daviskacer/odin/hardware/analog.kicad_sch

## KiCad design hardware/analog.kicad_sch (2026-10-21)

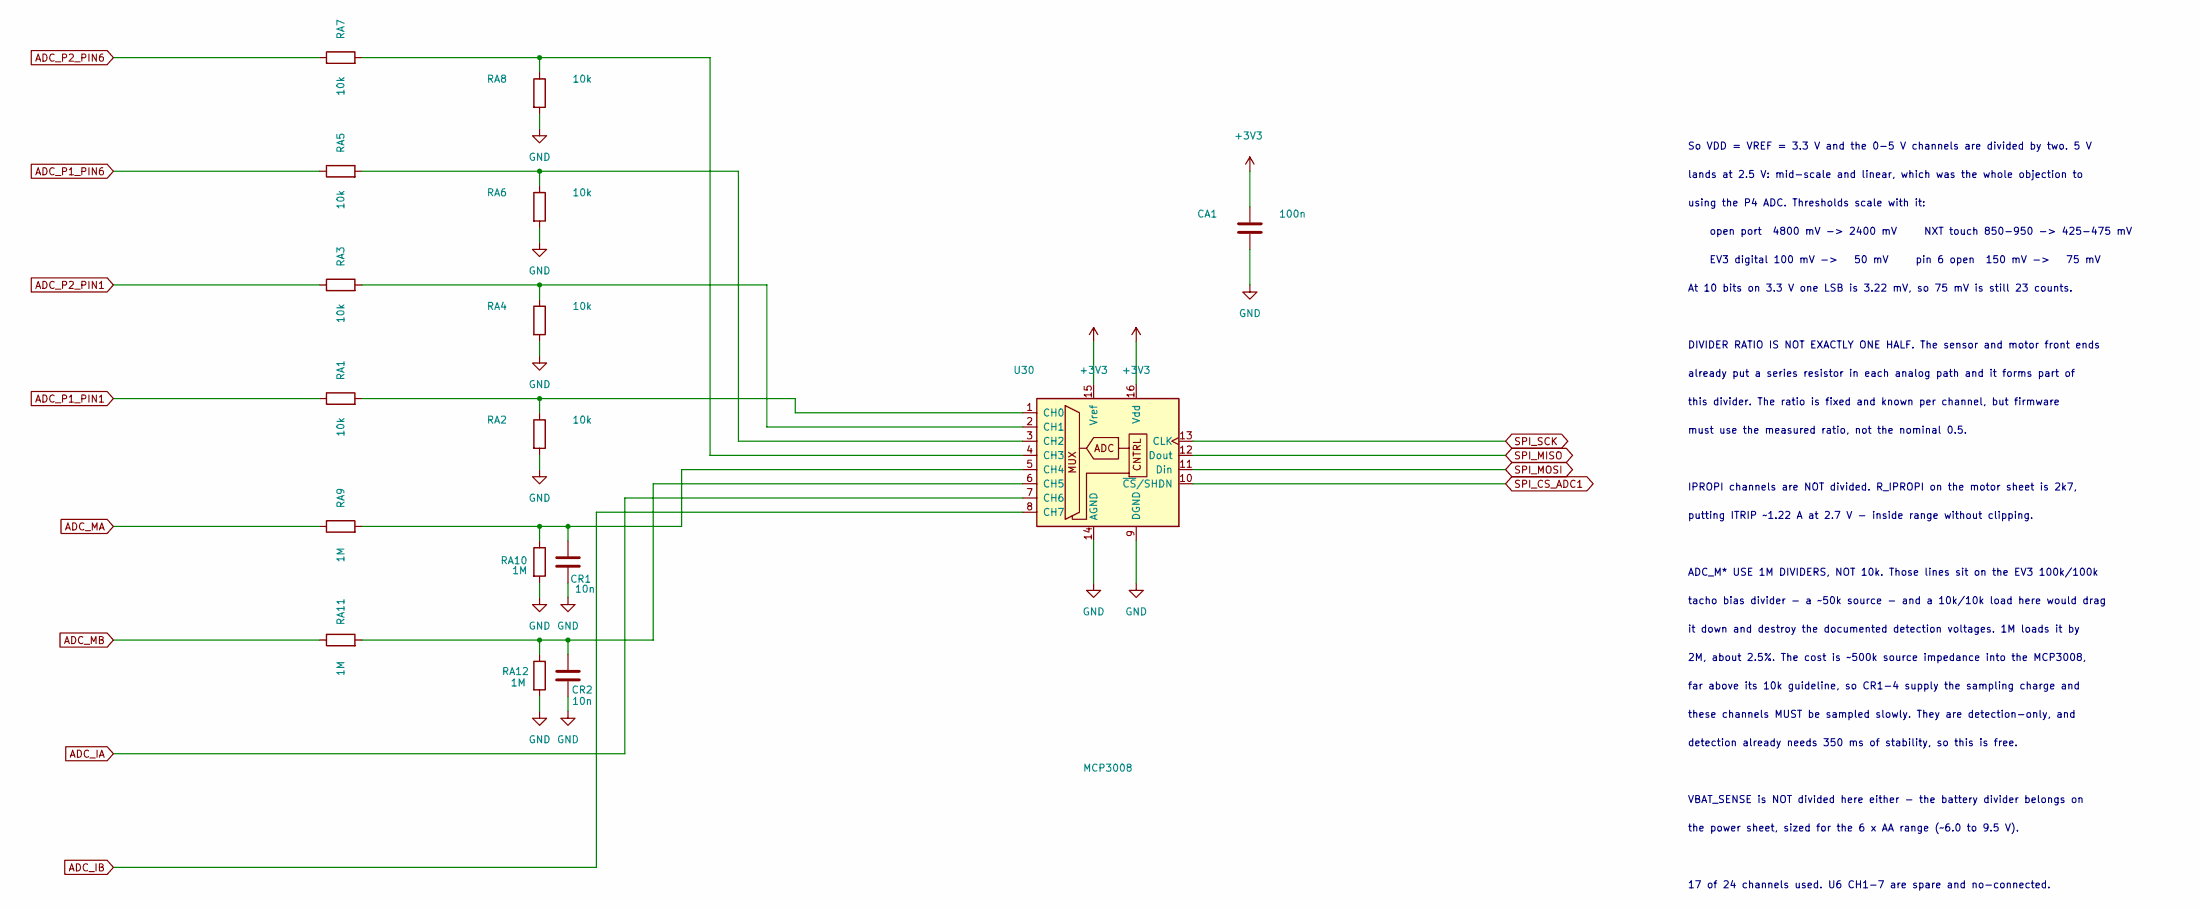
[picture p2: schematic analog.kicad_sch]

Parts:
CA1: 100n; C_0603_1608Metric
CR1, CR2: 10n; C_0603_1608Metric
RA1, RA2, RA3, RA4, RA5, RA6, RA7, RA8: 10k; R_0603_1608Metric
RA9, RA10, RA11, RA12: 1M; R_0603_1608Metric
U30: MCP3008; DIP-16_W7.62mm

Connections:
+3V3: CA1.1, U30.15 (Vref), U30.16 (Vdd)
ADC_IA: U30.7 (CH6)
ADC_IB: U30.8 (CH7)
ADC_MA: RA9.1
ADC_MB: RA11.1
ADC_P1_PIN1: RA1.1
ADC_P1_PIN6: RA5.1
ADC_P2_PIN1: RA3.1
ADC_P2_PIN6: RA7.1
GND: CA1.2, CR1.2, CR2.2, RA2.2, RA4.2, RA6.2, RA8.2, RA10.2, RA12.2, U30.9 (DGND), U30.14 (AGND)
unnamed: CR1.1, RA9.2, RA10.1, U30.5 (CH4)
unnamed: CR2.1, RA11.2, RA12.1, U30.6 (CH5)
unnamed: RA1.2, RA2.1, U30.1 (CH0)
unnamed: RA3.2, RA4.1, U30.2 (CH1)
unnamed: RA5.2, RA6.1, U30.3 (CH2)
unnamed: RA7.2, RA8.1, U30.4 (CH3)
SPI_CS_ADC1: U30.10 (~CS/SHDN)
SPI_MISO: U30.12 (Dout)
SPI_MOSI: U30.11 (Din)
SPI_SCK: U30.13 (CLK)

Notes on the sheet:
these channels MUST be sampled slowly. They are detection-only, and
At 10 bits on 3.3 V one LSB is 3.22 mV, so 75 mV is still 23 counts.
tacho bias divider - a ~50k source - and a 10k/10k load here would drag
putting ITRIP ~1.22 A at 2.7 V - inside range without clipping.
detection already needs 350 ms of stability, so this is free.
IPROPI channels are NOT divided. R_IPROPI on the motor sheet is 2k7,
ADC_M* USE 1M DIVIDERS, NOT 10k. Those lines sit on the EV3 100k/100k
must use the measured ratio, not the nominal 0.5.
lands at 2.5 V: mid-scale and linear, which was the whole objection to
already put a series resistor in each analog path and it forms part of
using the P4 ADC. Thresholds scale with it:
open port 4800 mV -> 2400 mV NXT touch 850-950 -> 425-475 mV
the power sheet, sized for the 6 x AA range (~6.0 to 9.5 V).
VBAT_SENSE is NOT divided here either - the battery divider belongs on
2M, about 2.5%. The cost is ~500k source impedance into the MCP3008,
far above its 10k guideline, so CR1-4 supply the sampling charge and
17 of 24 channels used. U6 CH1-7 are spare and no-connected.
EV3 digital 100 mV -> 50 mV pin 6 open 150 mV -> 75 mV
it down and destroy the documented detection voltages. 1M loads it by
So VDD = VREF = 3.3 V and the 0-5 V channels are divided by two. 5 V
this divider. The ratio is fixed and known per channel, but firmware
DIVIDER RATIO IS NOT EXACTLY ONE HALF. The sensor and motor front ends
