daviskacer/odin/hardware/devio.kicad_sch

## KiCad design hardware/devio.kicad_sch (2026-10-21)

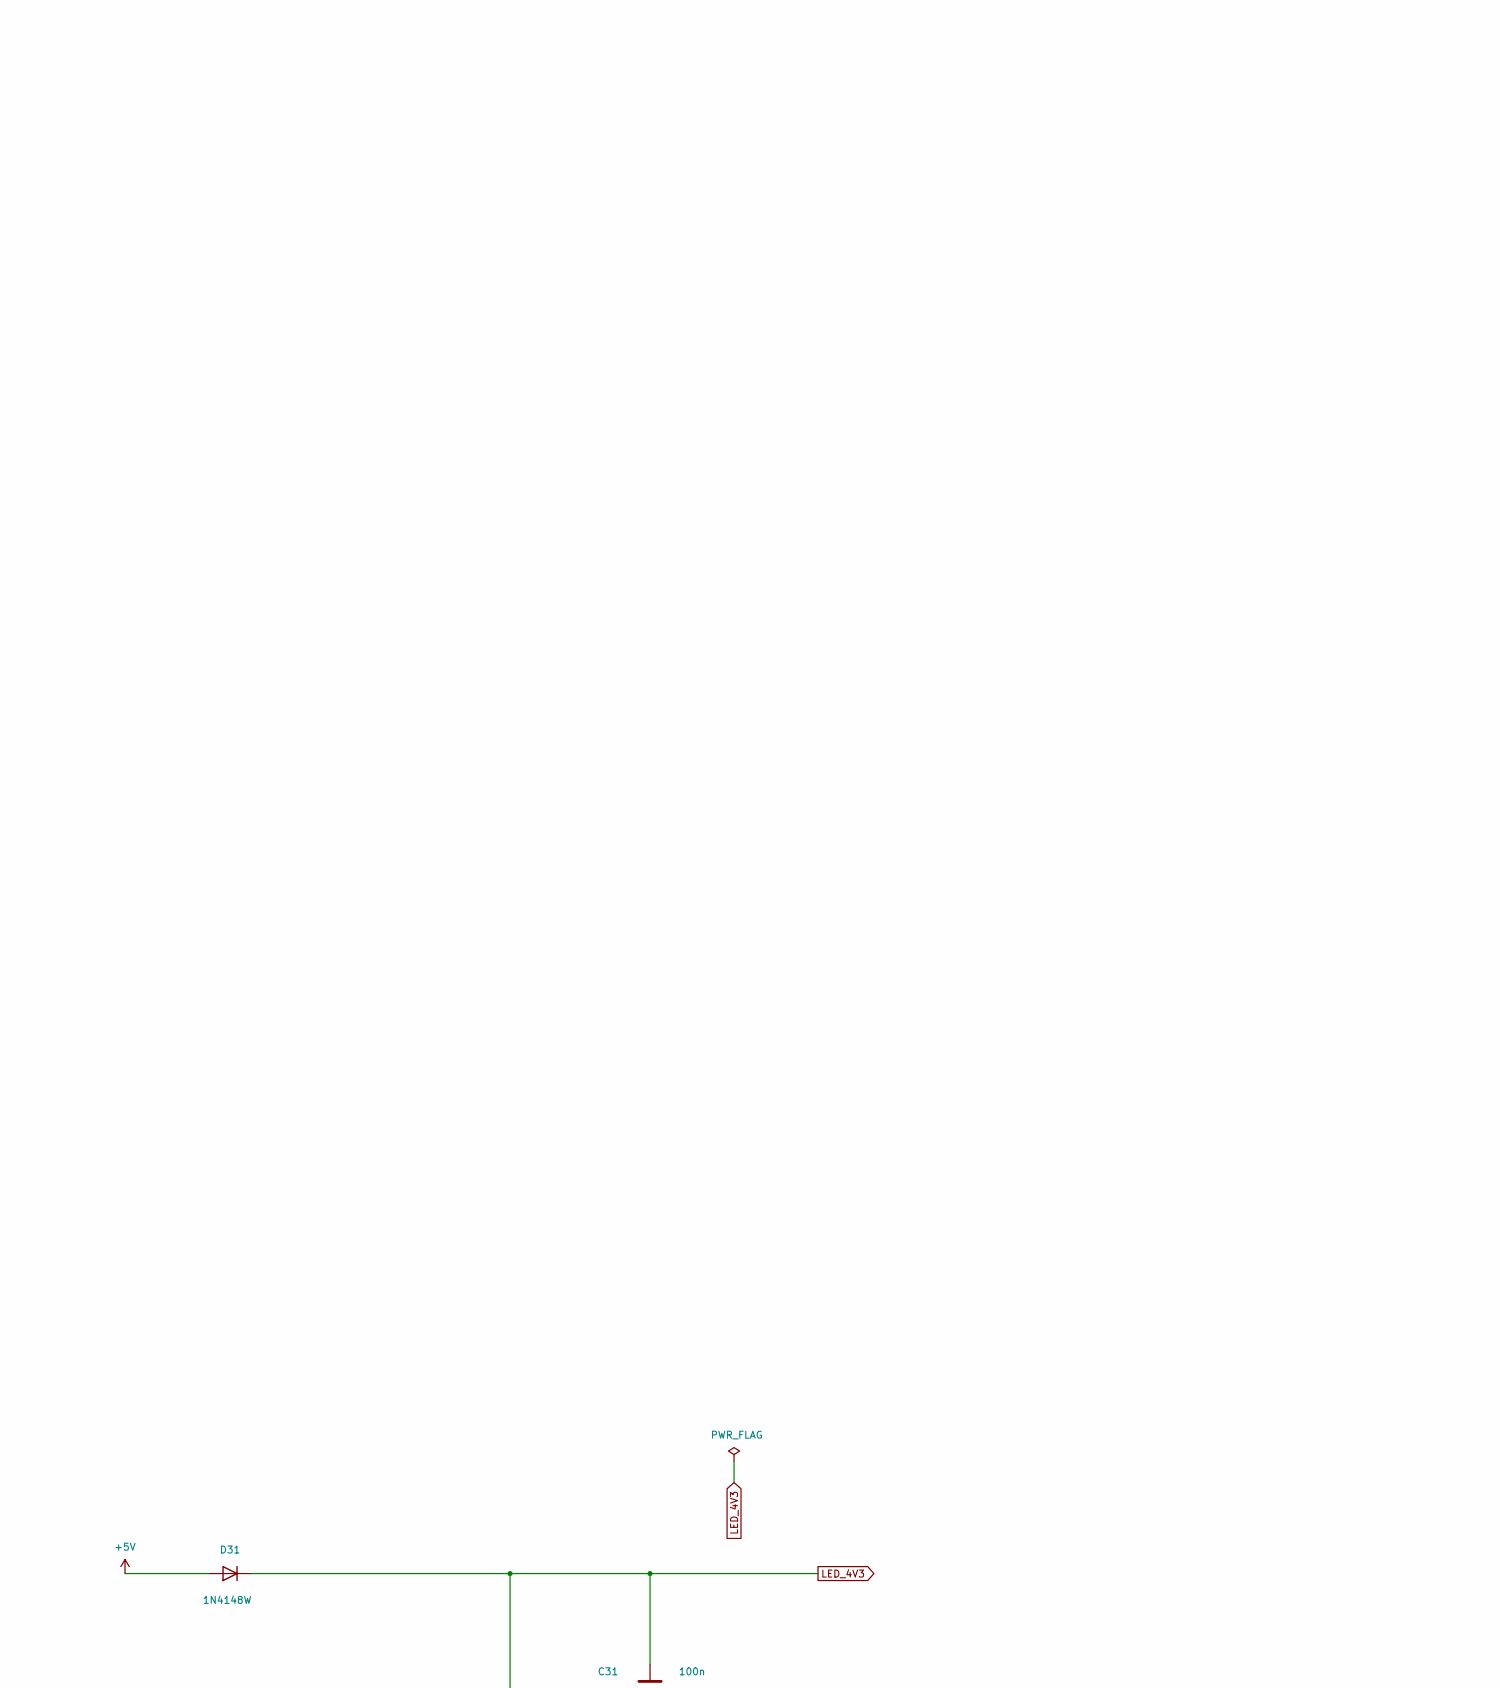
[picture p3: schematic devio.kicad_sch, part in row 1, column 1]

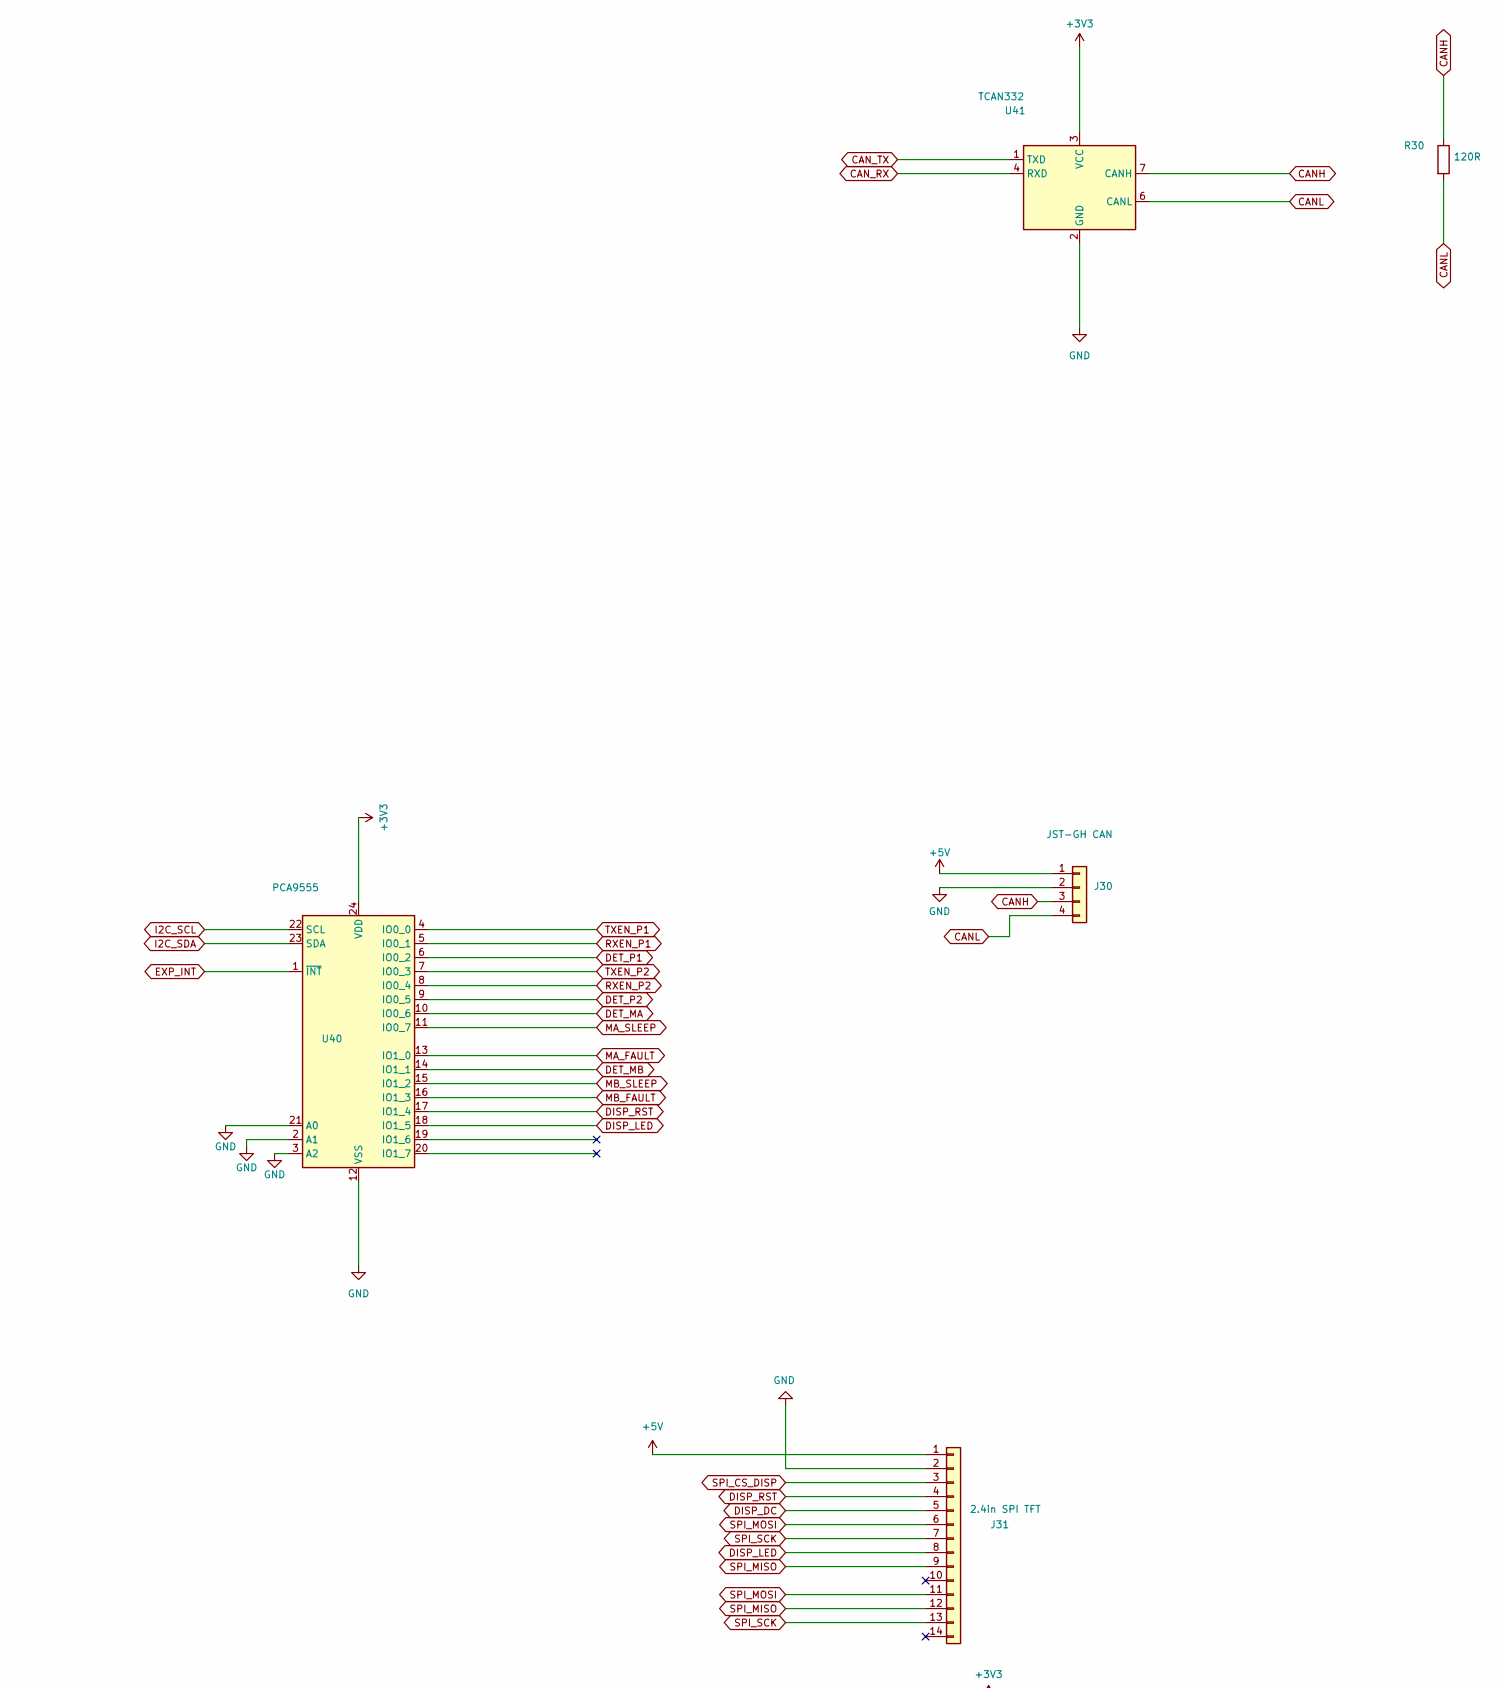
[picture p4: schematic devio.kicad_sch, part in row 1, column 2]

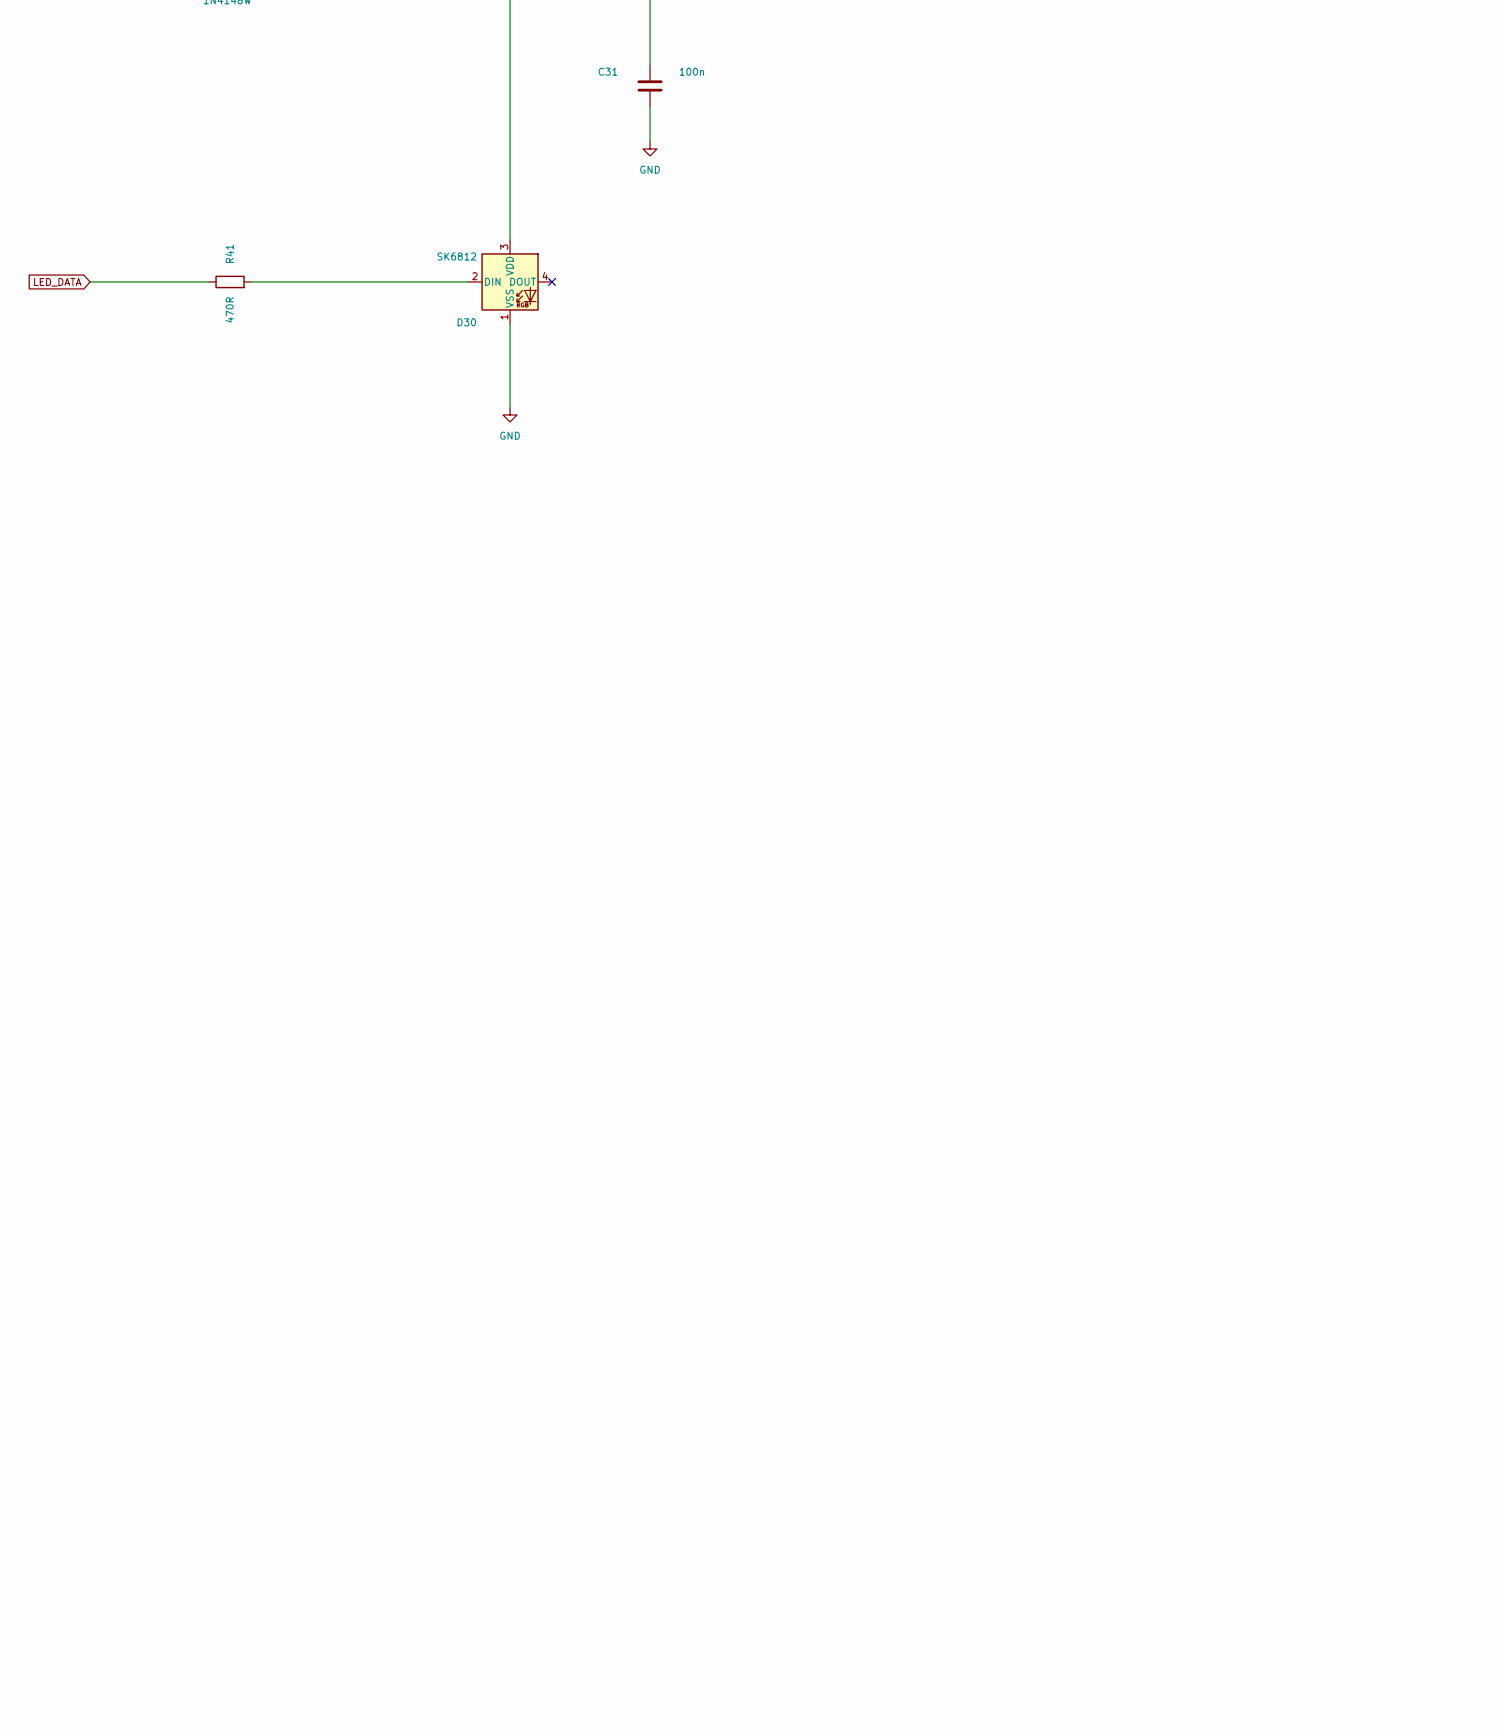
[picture p5: schematic devio.kicad_sch, part in row 2, column 1]

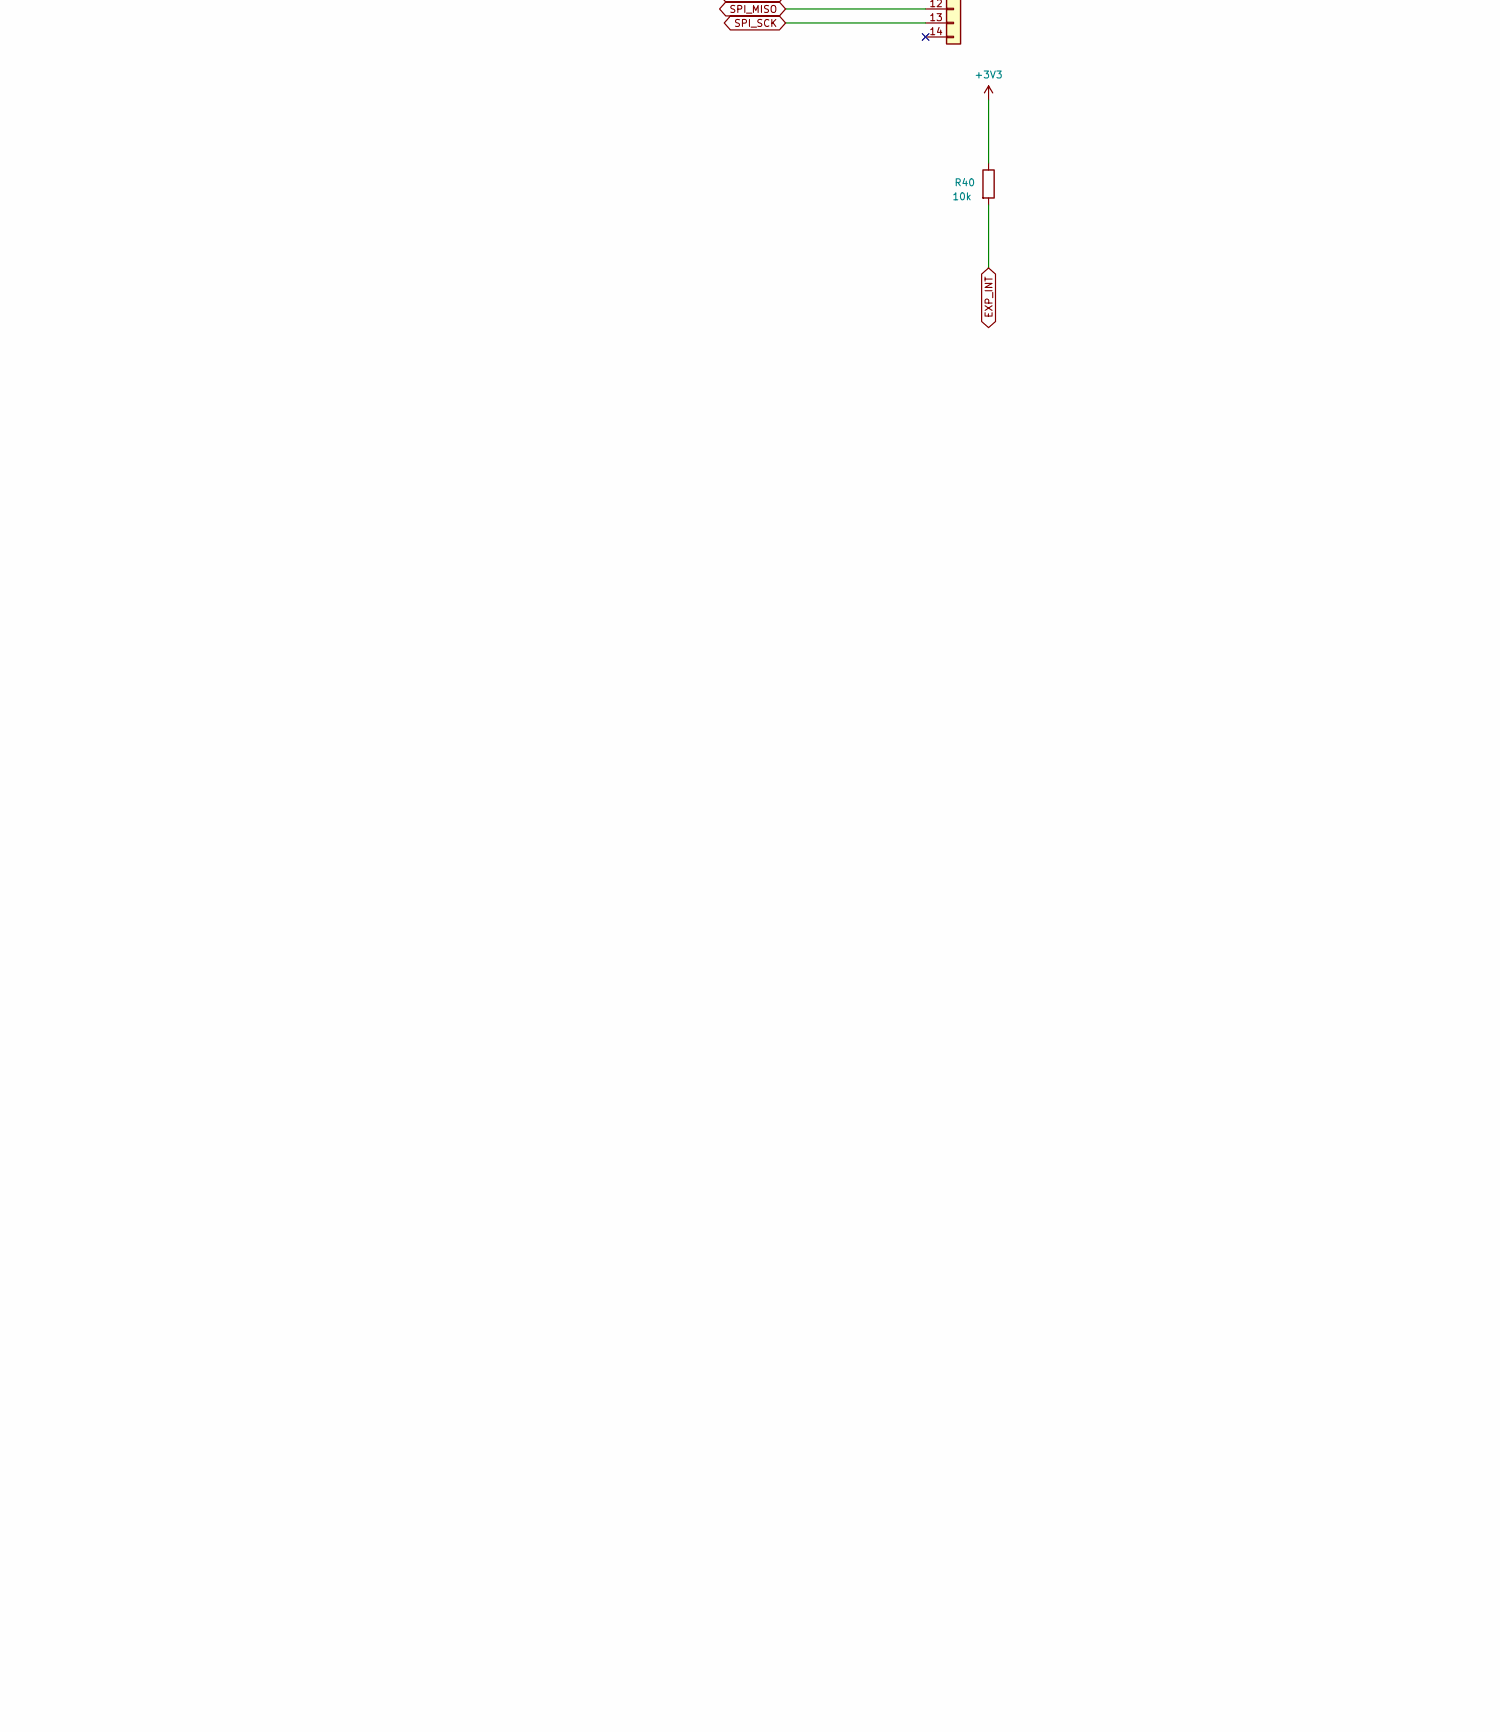
[picture p6: schematic devio.kicad_sch, part in row 2, column 2]

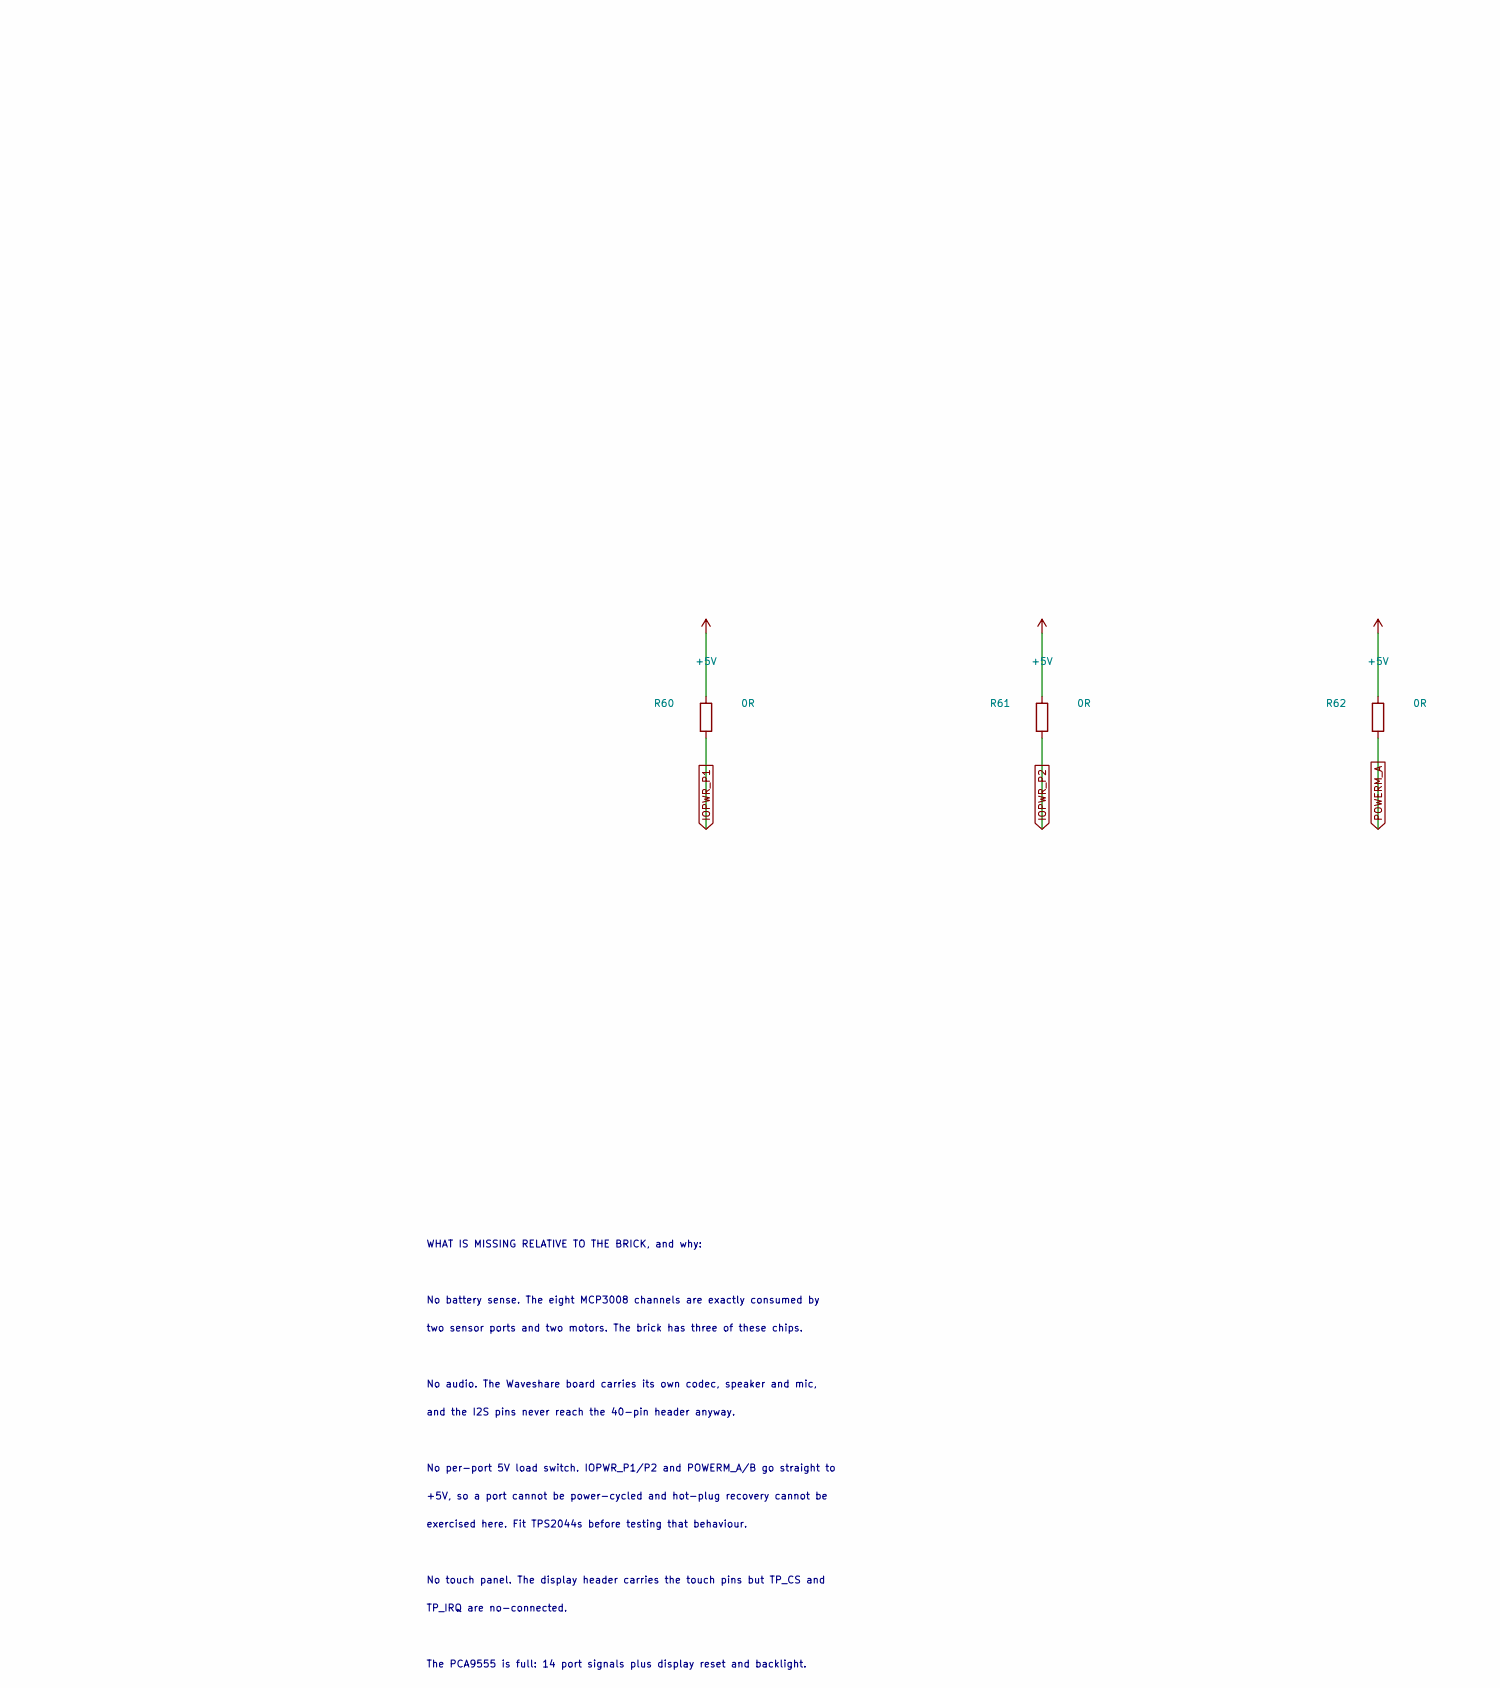
[picture p7: schematic devio.kicad_sch, part in row 3, column 1]

Parts:
C31: 100n; C_0603_1608Metric
D30: SK6812; LED_OPSCO_SK6812_PLCC4_5.0x5.0mm_P3.1mm
D31: 1N4148W; D_SOD-123
J30: JST-GH CAN; JST_GH_SM04B-GHS-TB_1x04-1MP_P1.25mm_Horizontal
J31: 2.4in SPI TFT; PinHeader_1x14_P2.54mm_Vertical
R30: 120R; R_0805_2012Metric
R40: 10k; R_0603_1608Metric
R41: 470R; R_0603_1608Metric
R60, R61, R62, R63: 0R; R_0805_2012Metric
U40: PCA9555; TSSOP-24_4.4x7.8mm_P0.65mm
U41: TCAN332; SOIC-8_3.9x4.9mm_P1.27mm

Connections:
+3V3: R40.1, U40.24 (VDD), U41.3 (VCC)
+5V: D31.2 (A), J30.1, J31.1, R60.1, R61.1, R62.1, R63.1
CANH: J30.3, R30.1, U41.7 (CANH)
CANL: J30.4, R30.2, U41.6 (CANL)
CAN_RX: U41.4 (RXD)
CAN_TX: U41.1 (TXD)
DET_MA: U40.10 (IO0_6)
DET_MB: U40.14 (IO1_1)
DET_P1: U40.6 (IO0_2)
DET_P2: U40.9 (IO0_5)
DISP_DC: J31.5
DISP_LED: J31.8, U40.18 (IO1_5)
DISP_RST: J31.4, U40.17 (IO1_4)
EXP_INT: R40.2, U40.1 (~INT)
GND: C31.2, D30.1 (VSS), J30.2, J31.2, U40.2 (A1), U40.3 (A2), U40.12 (VSS), U40.21 (A0), U41.2 (GND)
I2C_SCL: U40.22 (SCL)
I2C_SDA: U40.23 (SDA)
IOPWR_P1: R60.2
IOPWR_P2: R61.2
LED_4V3: C31.1, D30.3 (VDD), D31.1 (K)
LED_DATA: R41.1
MA_FAULT: U40.13 (IO1_0)
MA_SLEEP: U40.11 (IO0_7)
MB_FAULT: U40.16 (IO1_3)
MB_SLEEP: U40.15 (IO1_2)
unnamed: D30.2 (DIN), R41.2
POWERM_A: R62.2
POWERM_B: R63.2
RXEN_P1: U40.5 (IO0_1)
RXEN_P2: U40.8 (IO0_4)
SPI_CS_DISP: J31.3
SPI_MISO: J31.9, J31.12
SPI_MOSI: J31.6, J31.11
SPI_SCK: J31.7, J31.13
TXEN_P1: U40.4 (IO0_0)
TXEN_P2: U40.7 (IO0_3)

Notes on the sheet:
No audio. The Waveshare board carries its own codec, speaker and mic,
WHAT IS MISSING RELATIVE TO THE BRICK, and why:
two sensor ports and two motors. The brick has three of these chips.
No per-port 5V load switch. IOPWR_P1/P2 and POWERM_A/B go straight to
exercised here. Fit TPS2044s before testing that behaviour.
TP_IRQ are no-connected.
No touch panel. The display header carries the touch pins but TP_CS and
+5V, so a port cannot be power-cycled and hot-plug recovery cannot be
The PCA9555 is full: 14 port signals plus display reset and backlight.
and the I2S pins never reach the 40-pin header anyway.
No battery sense. The eight MCP3008 channels are exactly consumed by
