daviskacer/odin/hardware/header.kicad_sch

## KiCad design hardware/header.kicad_sch (2026-10-21)

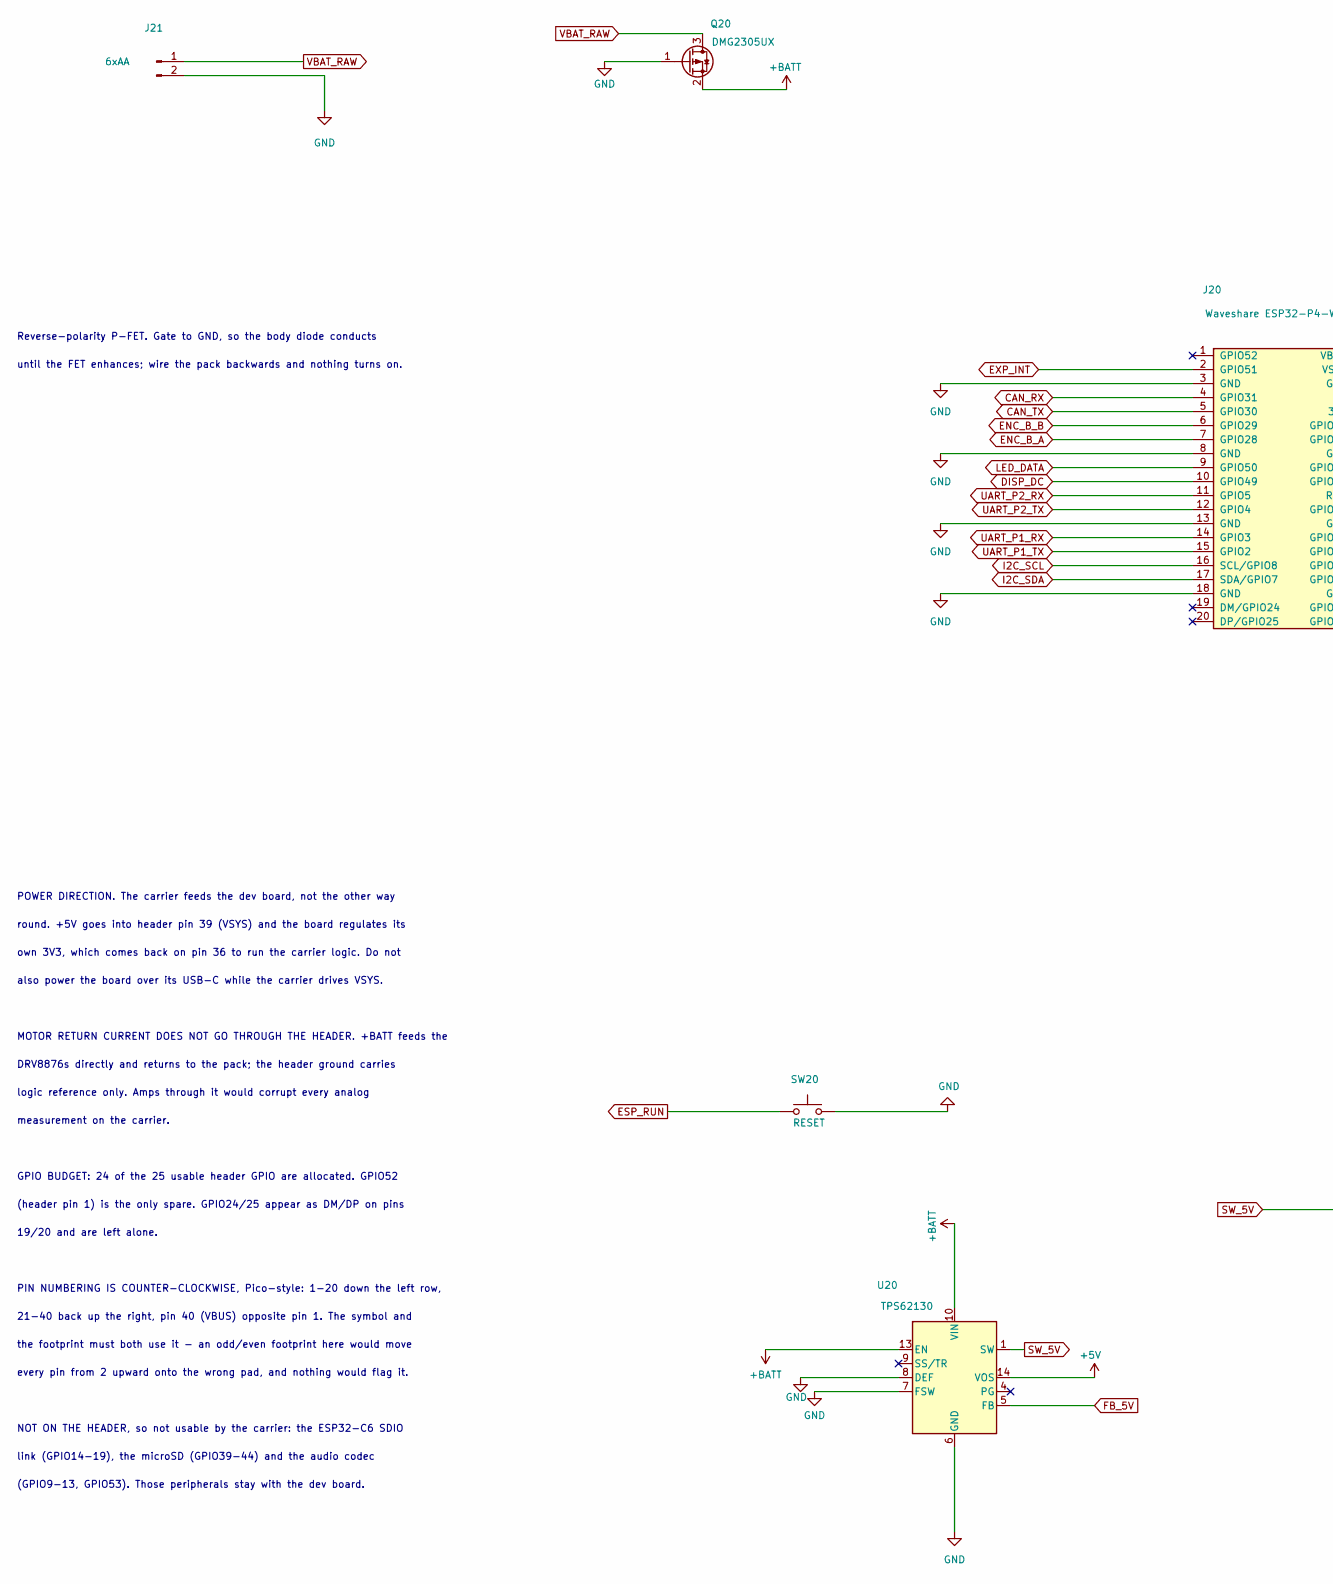
[picture p8: schematic header.kicad_sch, part in row 1, column 1]

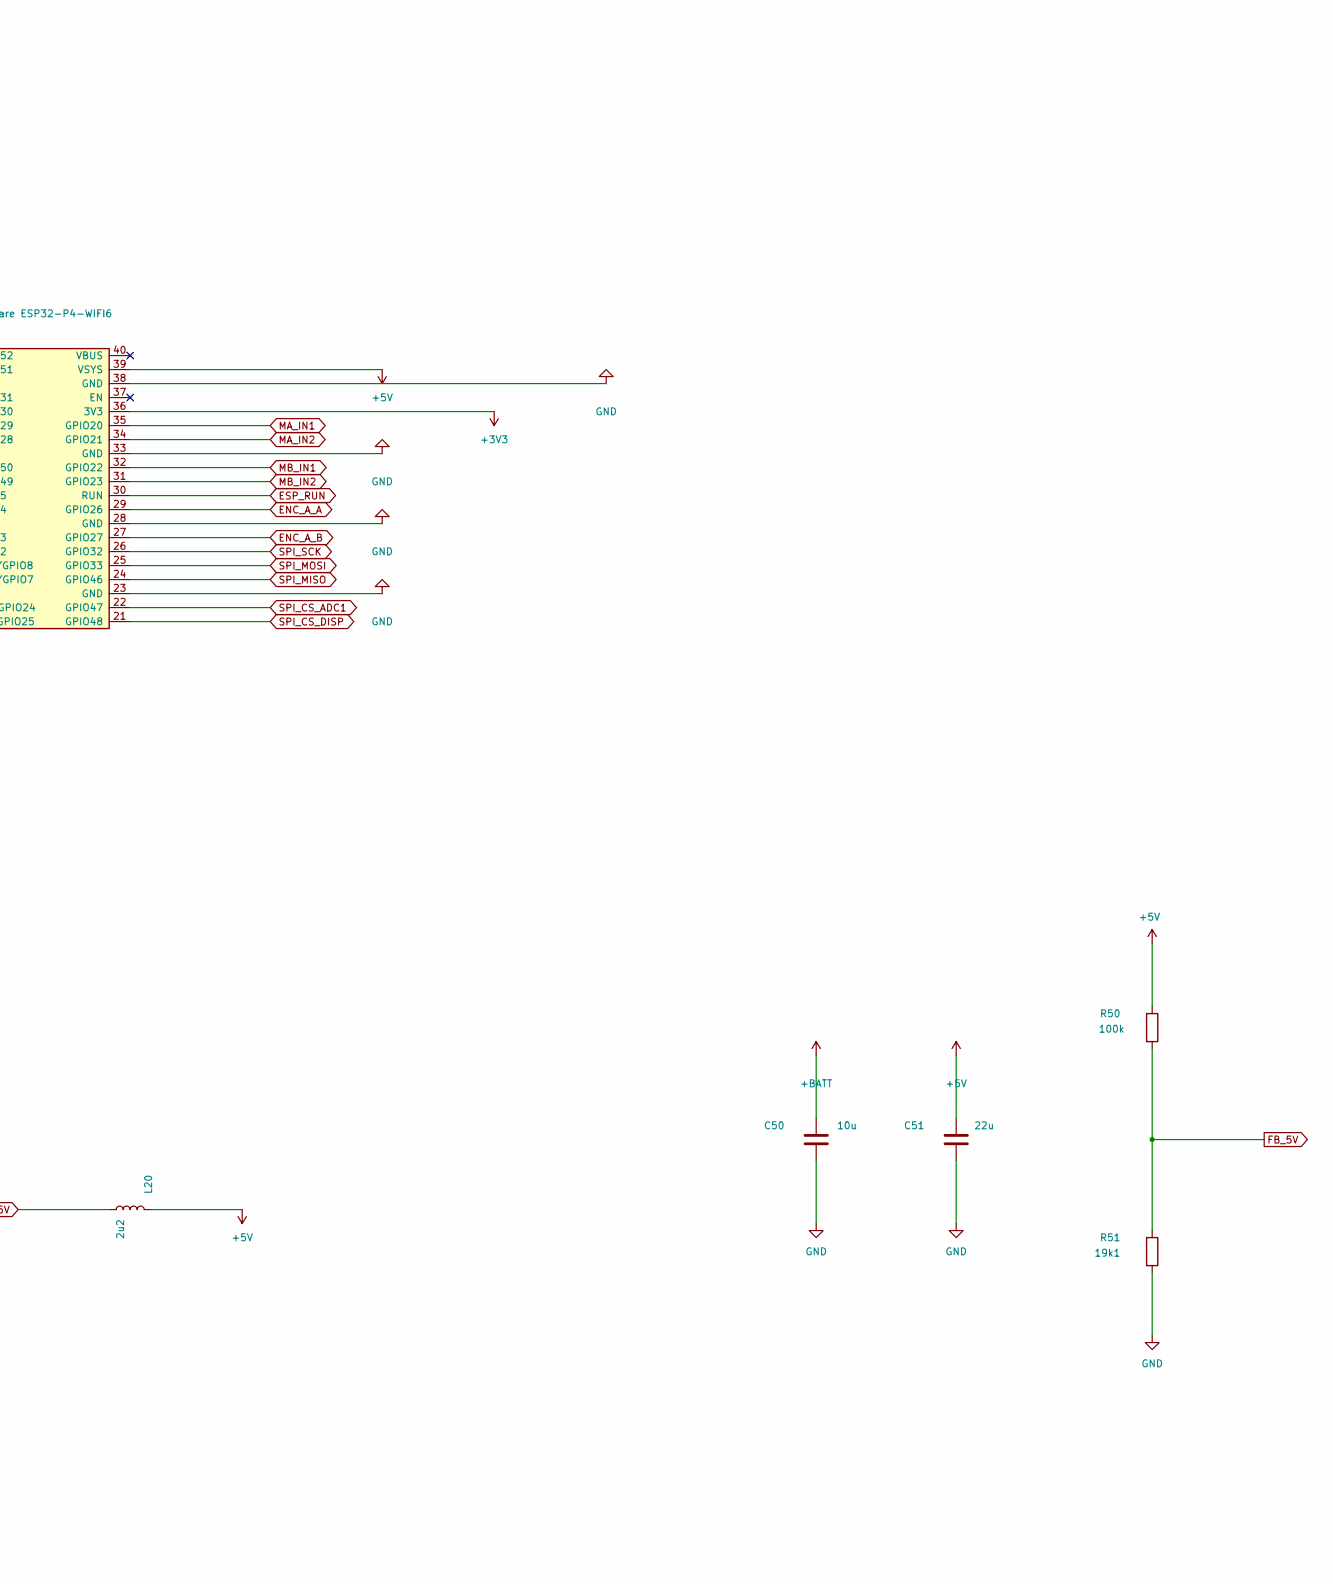
[picture p9: schematic header.kicad_sch, part in row 1, column 2]

Parts:
C50: 10u; C_0805_2012Metric
C51: 22u; C_0805_2012Metric
J20: Waveshare ESP32-P4-WIFI6; Waveshare_ESP32-P4-WIFI6_2x20_P2.54mm_Socket
J21: 6xAA
L20: 2u2
Q20: DMG2305UX; SOT-23
R50: 100k; R_0603_1608Metric
R51: 19k1; R_0603_1608Metric
SW20: RESET; SW_Push_1P1T_NO_CK_KMR2
U20: TPS62130

Connections:
+3V3: J20.36 (3V3)
+5V: C51.1, J20.39 (VSYS), L20.2, R50.1, U20.14 (VOS)
+BATT: C50.1, Q20.2 (S), U20.10 (VIN), U20.11 (VIN), U20.12 (VIN), U20.13 (EN)
CAN_RX: J20.4 (GPIO31)
CAN_TX: J20.5 (GPIO30)
DISP_DC: J20.10 (GPIO49)
ENC_A_A: J20.29 (GPIO26)
ENC_A_B: J20.27 (GPIO27)
ENC_B_A: J20.7 (GPIO28)
ENC_B_B: J20.6 (GPIO29)
ESP_RUN: J20.30 (RUN), SW20.1
EXP_INT: J20.2 (GPIO51)
FB_5V: R50.2, R51.1, U20.5 (FB)
GND: C50.2, C51.2, J20.3 (GND), J20.8 (GND), J20.13 (GND), J20.18 (GND), J20.23 (GND), J20.28 (GND), J20.33 (GND), J20.38 (GND), J21.2, Q20.1 (G), R51.2, SW20.2, U20.6 (GND), U20.7 (FSW), U20.8 (DEF), U20.15 (GND), U20.16 (GND), U20.17 (GND)
I2C_SCL: J20.16 (SCL/GPIO8)
I2C_SDA: J20.17 (SDA/GPIO7)
LED_DATA: J20.9 (GPIO50)
MA_IN1: J20.35 (GPIO20)
MA_IN2: J20.34 (GPIO21)
MB_IN1: J20.32 (GPIO22)
MB_IN2: J20.31 (GPIO23)
SPI_CS_ADC1: J20.22 (GPIO47)
SPI_CS_DISP: J20.21 (GPIO48)
SPI_MISO: J20.24 (GPIO46)
SPI_MOSI: J20.25 (GPIO33)
SPI_SCK: J20.26 (GPIO32)
SW_5V: L20.1, U20.1 (SW), U20.2 (SW), U20.3 (SW)
UART_P1_RX: J20.14 (GPIO3)
UART_P1_TX: J20.15 (GPIO2)
UART_P2_RX: J20.11 (GPIO5)
UART_P2_TX: J20.12 (GPIO4)
VBAT_RAW: J21.1, Q20.3 (D)

Notes on the sheet:
the footprint must both use it - an odd/even footprint here would move
also power the board over its USB-C while the carrier drives VSYS.
21-40 back up the right, pin 40 (VBUS) opposite pin 1. The symbol and
(GPIO9-13, GPIO53). Those peripherals stay with the dev board.
Reverse-polarity P-FET. Gate to GND, so the body diode conducts
DRV8876s directly and returns to the pack; the header ground carries
NOT ON THE HEADER, so not usable by the carrier: the ESP32-C6 SDIO
link (GPIO14-19), the microSD (GPIO39-44) and the audio codec
until the FET enhances; wire the pack backwards and nothing turns on.
MOTOR RETURN CURRENT DOES NOT GO THROUGH THE HEADER. +BATT feeds the
measurement on the carrier.
POWER DIRECTION. The carrier feeds the dev board, not the other way
round. +5V goes into header pin 39 (VSYS) and the board regulates its
19/20 and are left alone.
PIN NUMBERING IS COUNTER-CLOCKWISE, Pico-style: 1-20 down the left row,
every pin from 2 upward onto the wrong pad, and nothing would flag it.
GPIO BUDGET: 24 of the 25 usable header GPIO are allocated. GPIO52
(header pin 1) is the only spare. GPIO24/25 appear as DM/DP on pins
logic reference only. Amps through it would corrupt every analog
own 3V3, which comes back on pin 36 to run the carrier logic. Do not
