daviskacer/odin/hardware/motor_ports.kicad_sch

## KiCad design hardware/motor_ports.kicad_sch (2026-10-21)

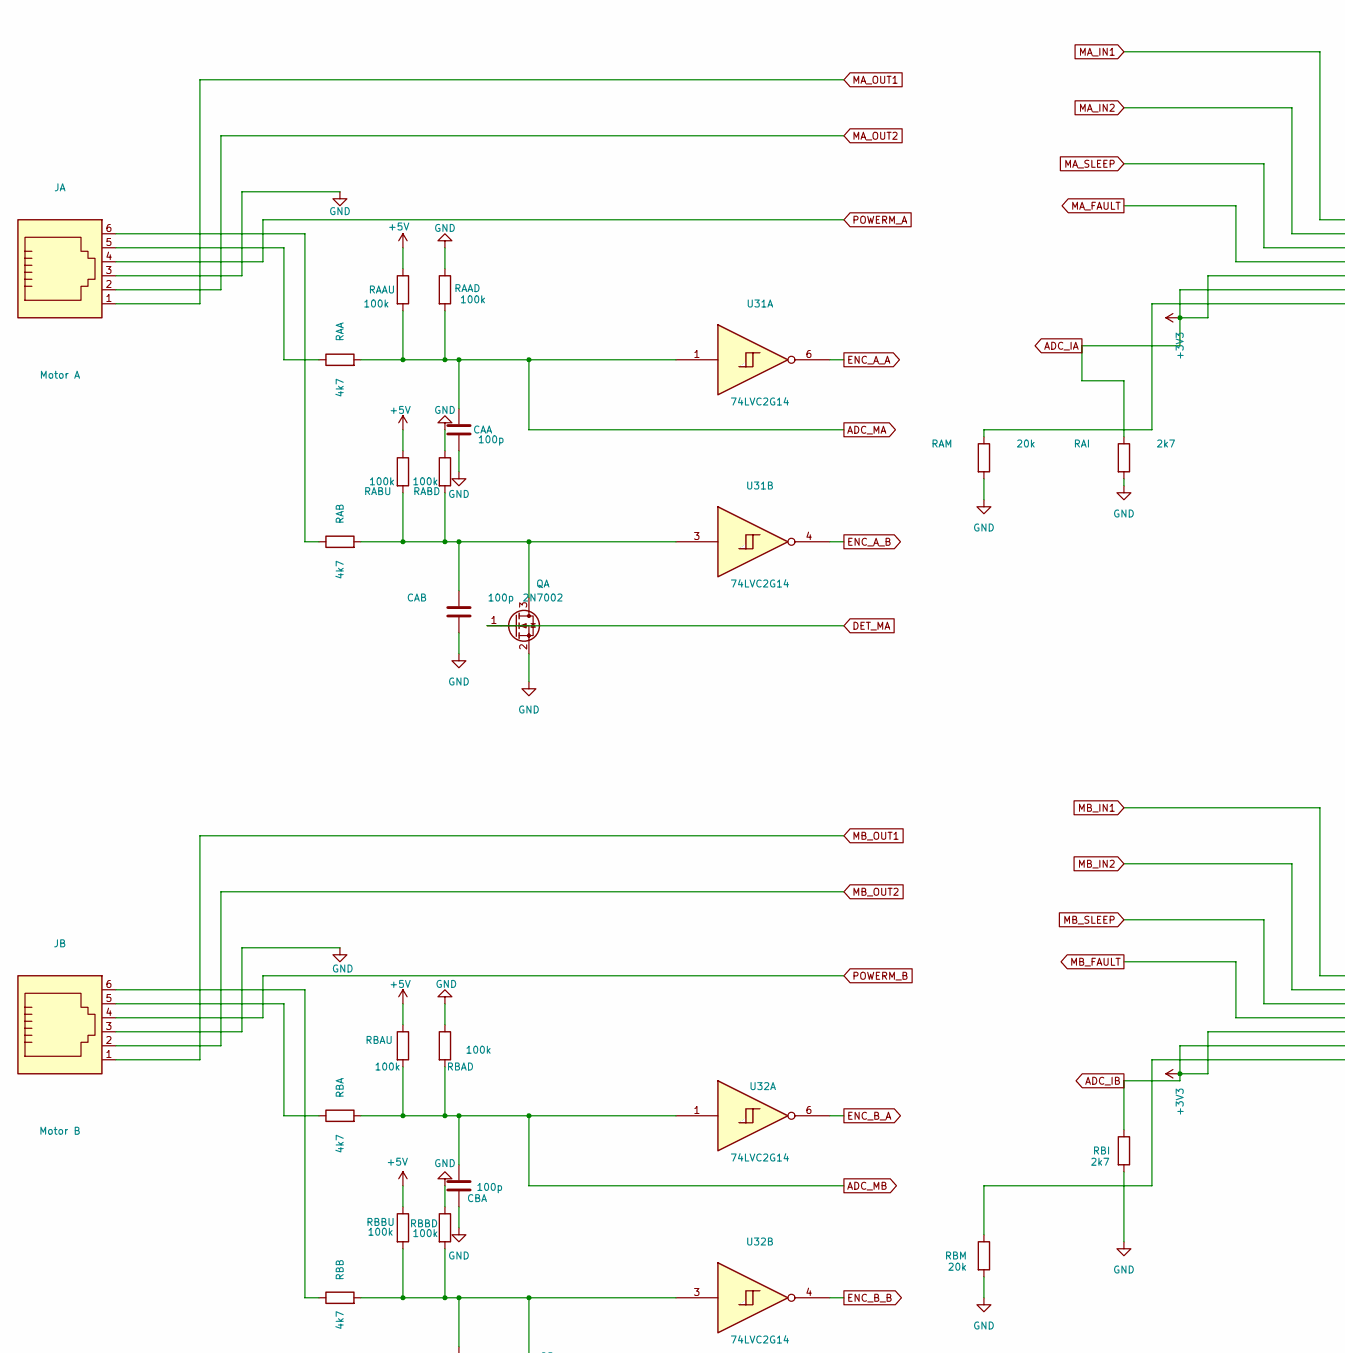
[picture p10: schematic motor_ports.kicad_sch, part in row 1, column 1]

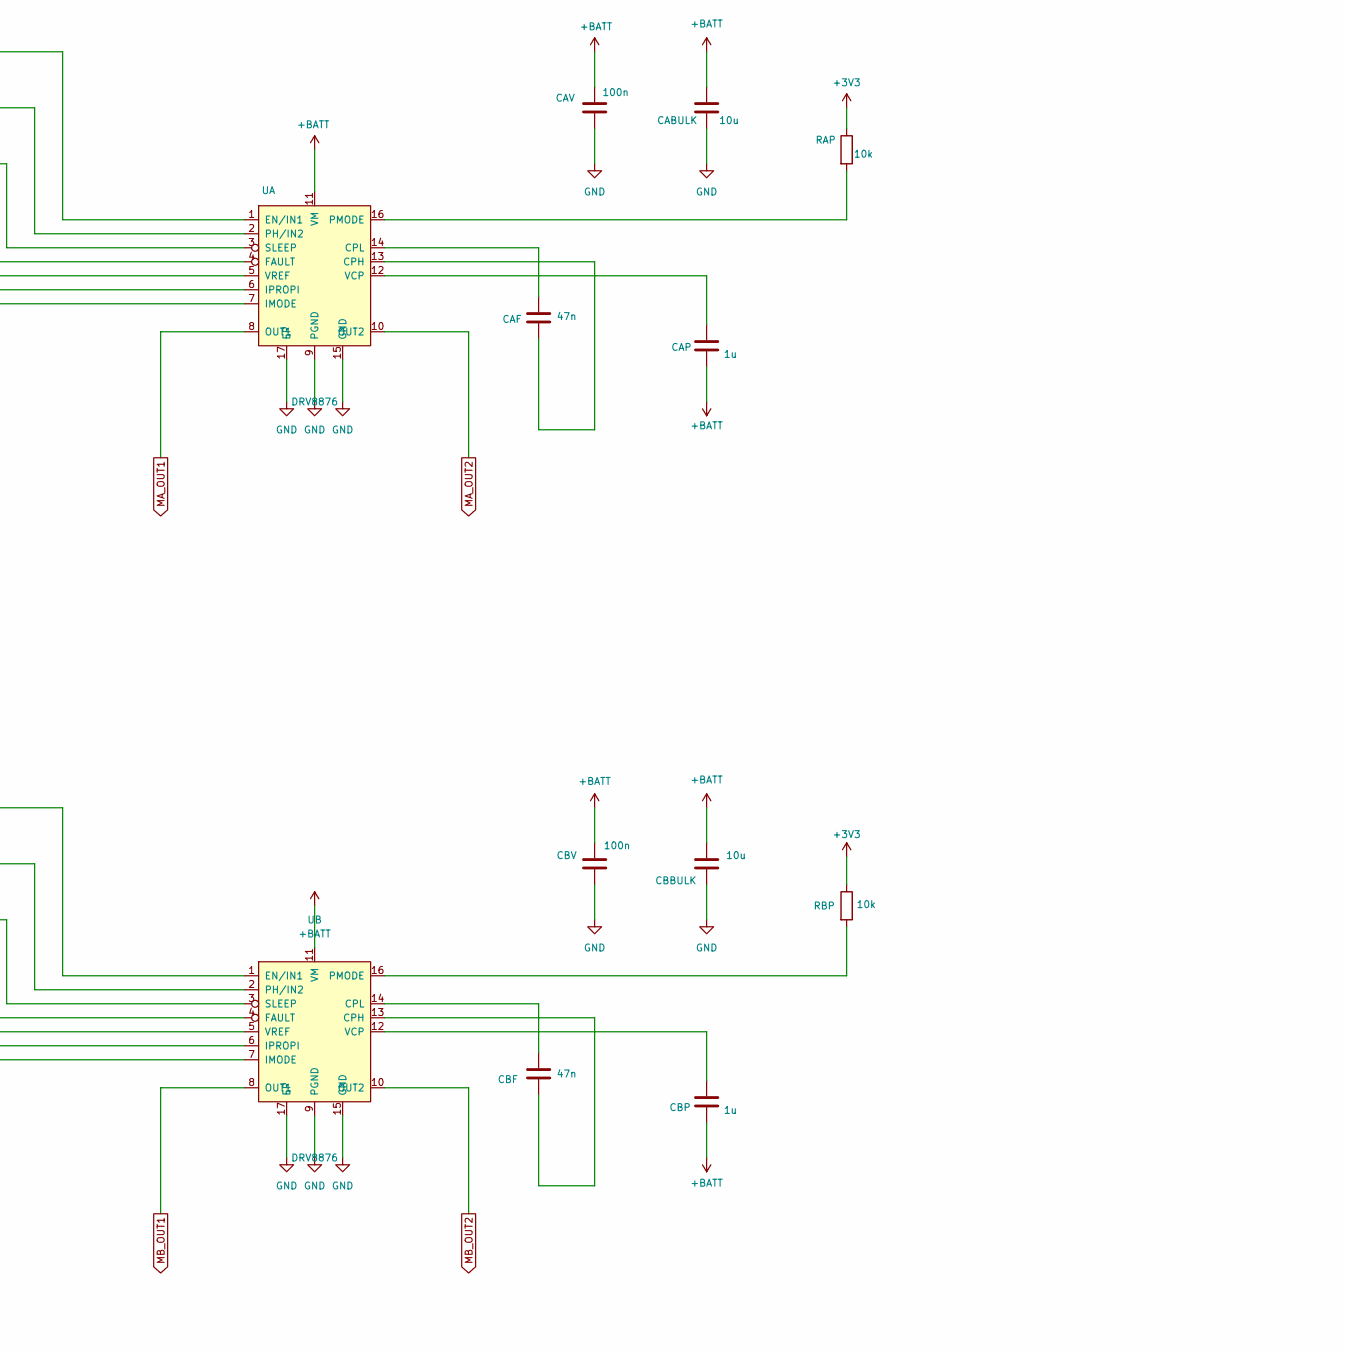
[picture p11: schematic motor_ports.kicad_sch, part in row 1, column 2]

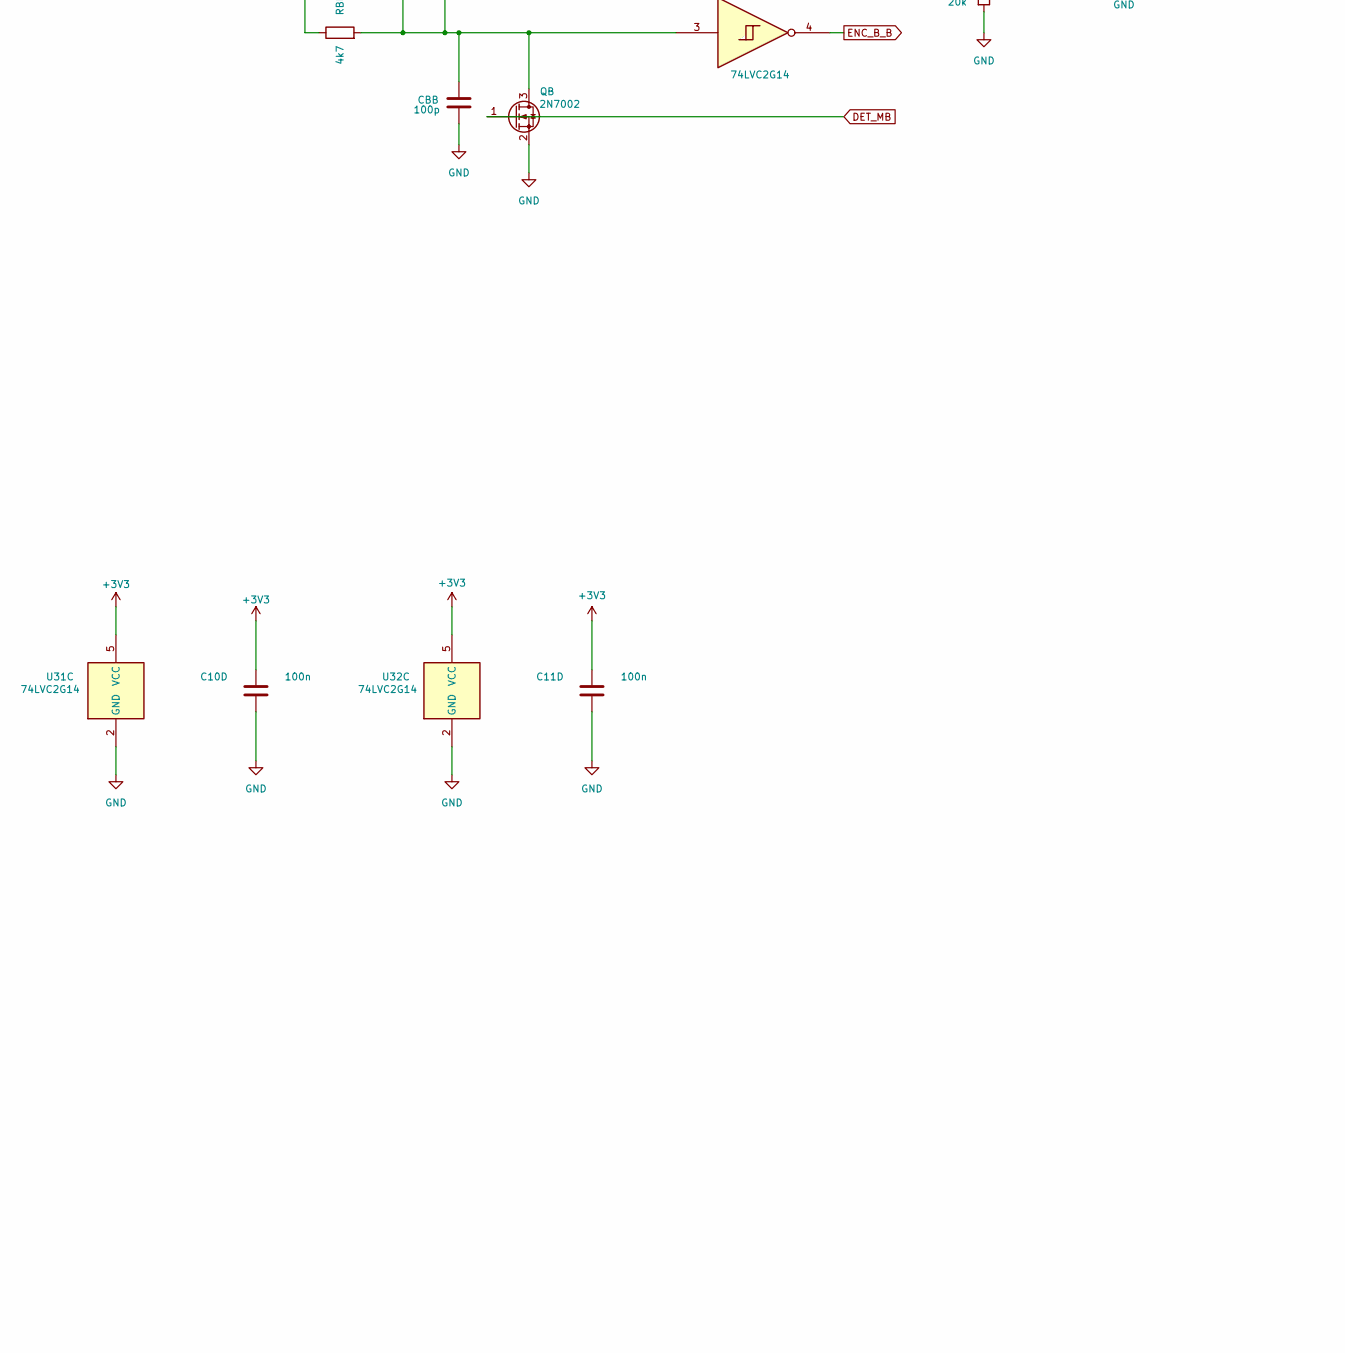
[picture p12: schematic motor_ports.kicad_sch, part in row 2, column 1]

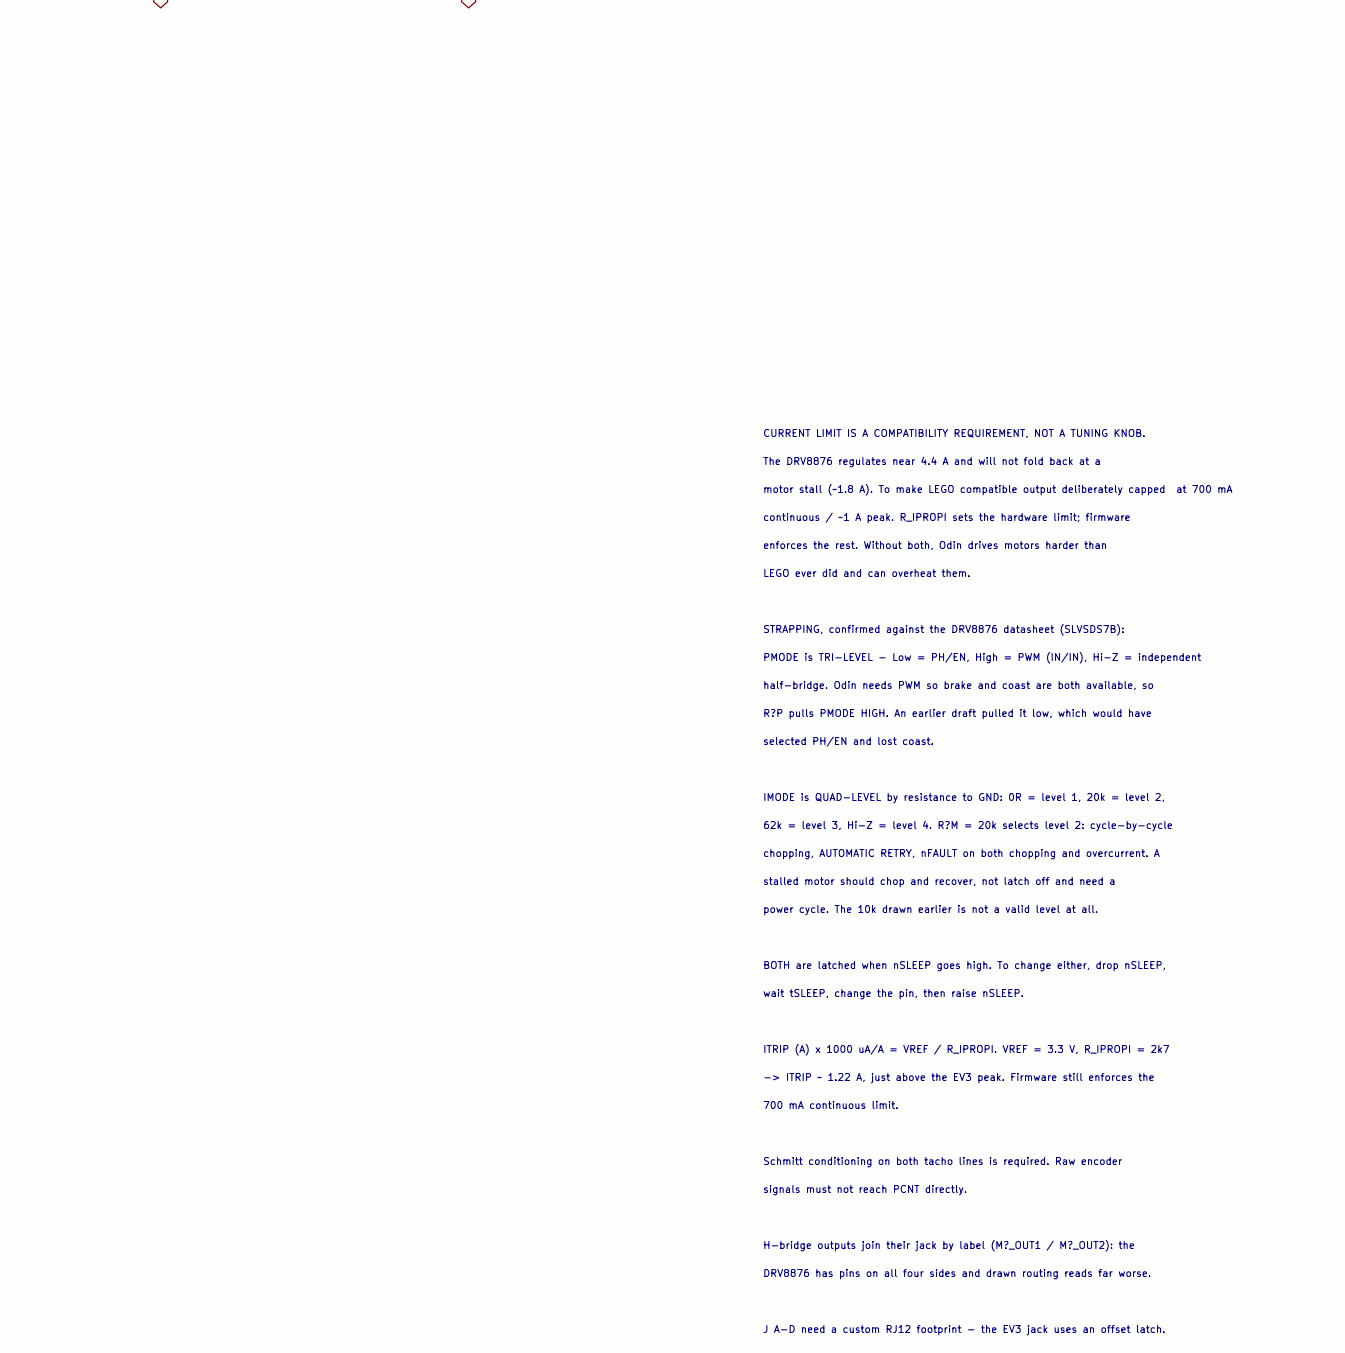
[picture p13: schematic motor_ports.kicad_sch, part in row 2, column 2]

Parts:
C10D, C11D: 100n; C_0603_1608Metric
CAA: 100p; C_0603_1608Metric
CAB: 100p; C_0603_1608Metric
CABULK: 10u; C_0603_1608Metric
CAF: 47n; C_0603_1608Metric
CAP: 1u; C_0603_1608Metric
CAV: 100n; C_0603_1608Metric
CBA: 100p; C_0603_1608Metric
CBB: 100p; C_0603_1608Metric
CBBULK: 10u; C_0603_1608Metric
CBF: 47n; C_0603_1608Metric
CBP: 1u; C_0603_1608Metric
CBV: 100n; C_0603_1608Metric
JA: Motor A
JB: Motor B
QA: 2N7002; SOT-23
QB: 2N7002; SOT-23
RAA: 4k7; R_0603_1608Metric
RAAD: 100k; R_0603_1608Metric
RAAU: 100k; R_0603_1608Metric
RAB: 4k7; R_0603_1608Metric
RABD: 100k; R_0603_1608Metric
RABU: 100k; R_0603_1608Metric
RAI: 2k7; R_0603_1608Metric
RAM: 20k; R_0603_1608Metric
RAP: 10k; R_0603_1608Metric
RBA: 4k7; R_0603_1608Metric
RBAD: 100k; R_0603_1608Metric
RBAU: 100k; R_0603_1608Metric
RBB: 4k7; R_0603_1608Metric
RBBD: 100k; R_0603_1608Metric
RBBU: 100k; R_0603_1608Metric
RBI: 2k7; R_0603_1608Metric
RBM: 20k; R_0603_1608Metric
RBP: 10k; R_0603_1608Metric
U31, U32: 74LVC2G14; SOT-23-6
UA: DRV8876; HTSSOP-16-1EP_4.4x5mm_P0.65mm_EP3.4x5mm
UB: DRV8876; HTSSOP-16-1EP_4.4x5mm_P0.65mm_EP3.4x5mm

Connections:
+3V3: C10D.1, C11D.1, RAI.1, RAP.1, RBI.1, RBP.1, U31.5 (VCC), U32.5 (VCC), UA.5 (VREF), UA.6 (IPROPI), UB.5 (VREF), UB.6 (IPROPI)
+5V: RAAU.1, RABU.1, RBAU.1, RBBU.1
+BATT: CABULK.1, CAP.2, CAV.1, CBBULK.1, CBP.2, CBV.1, UA.11 (VM), UB.11 (VM)
ADC_MA: CAA.1, RAA.2, RAAD.2, RAAU.2, U31.1
ADC_MB: CBA.1, RBA.2, RBAD.2, RBAU.2, U32.1
DET_MA: QA.1 (G)
DET_MB: QB.1 (G)
ENC_A_A: U31.6
ENC_A_B: U31.4
ENC_B_A: U32.6
ENC_B_B: U32.4
GND: C10D.2, C11D.2, CAA.2, CAB.2, CABULK.2, CAV.2, CBA.2, CBB.2, CBBULK.2, CBV.2, JA.3, JB.3, QA.2 (S), QB.2 (S), RAAD.1, RABD.1, RAI.2, RAM.2, RBAD.1, RBBD.1, RBI.2, RBM.2, U31.2 (GND), U32.2 (GND), UA.9 (PGND), UA.15 (GND), UA.17 (EP), UB.9 (PGND), UB.15 (GND), UB.17 (EP)
MA_FAULT: UA.4 (FAULT)
MA_IN1: UA.1 (EN/IN1)
MA_IN2: UA.2 (PH/IN2)
MA_OUT1: JA.1, UA.8 (OUT1)
MA_OUT2: JA.2, UA.10 (OUT2)
MA_SLEEP: UA.3 (SLEEP)
MB_FAULT: UB.4 (FAULT)
MB_IN1: UB.1 (EN/IN1)
MB_IN2: UB.2 (PH/IN2)
MB_OUT1: JB.1, UB.8 (OUT1)
MB_OUT2: JB.2, UB.10 (OUT2)
MB_SLEEP: UB.3 (SLEEP)
unnamed: CAB.1, QA.3 (D), RAB.2, RABD.2, RABU.2, U31.3
unnamed: CAF.1, UA.14 (CPL)
unnamed: CAF.2, UA.13 (CPH)
unnamed: CAP.1, UA.12 (VCP)
unnamed: CBB.1, QB.3 (D), RBB.2, RBBD.2, RBBU.2, U32.3
unnamed: CBF.1, UB.14 (CPL)
unnamed: CBF.2, UB.13 (CPH)
unnamed: CBP.1, UB.12 (VCP)
unnamed: JA.5, RAA.1
unnamed: JA.6, RAB.1
unnamed: JB.5, RBA.1
unnamed: JB.6, RBB.1
unnamed: RAM.1, UA.7 (IMODE)
unnamed: RAP.2, UA.16 (PMODE)
unnamed: RBM.1, UB.7 (IMODE)
unnamed: RBP.2, UB.16 (PMODE)
POWERM_A: JA.4
POWERM_B: JB.4

Notes on the sheet:
H-bridge outputs join their jack by label (M?_OUT1 / M?_OUT2): the
stalled motor should chop and recover, not latch off and need a
signals must not reach PCNT directly.
IMODE is QUAD-LEVEL by resistance to GND: 0R = level 1, 20k = level 2,
wait tSLEEP, change the pin, then raise nSLEEP.
selected PH/EN and lost coast.
J A-D need a custom RJ12 footprint - the EV3 jack uses an offset latch.
-> ITRIP ~ 1.22 A, just above the EV3 peak. Firmware still enforces the
Schmitt conditioning on both tacho lines is required. Raw encoder
continuous / ~1 A peak. R_IPROPI sets the hardware limit; firmware
PMODE is TRI-LEVEL - Low = PH/EN, High = PWM (IN/IN), Hi-Z = independent
STRAPPING, confirmed against the DRV8876 datasheet (SLVSDS7B):
enforces the rest. Without both, Odin drives motors harder than
motor stall (~1.8 A). To make LEGO compatible output deliberately capped at 700 mA
chopping, AUTOMATIC RETRY, nFAULT on both chopping and overcurrent. A
BOTH are latched when nSLEEP goes high. To change either, drop nSLEEP,
700 mA continuous limit.
CURRENT LIMIT IS A COMPATIBILITY REQUIREMENT, NOT A TUNING KNOB.
62k = level 3, Hi-Z = level 4. R?M = 20k selects level 2: cycle-by-cycle
DRV8876 has pins on all four sides and drawn routing reads far worse.
power cycle. The 10k drawn earlier is not a valid level at all.
half-bridge. Odin needs PWM so brake and coast are both available, so
ITRIP (A) x 1000 uA/A = VREF / R_IPROPI. VREF = 3.3 V, R_IPROPI = 2k7
The DRV8876 regulates near 4.4 A and will not fold back at a
R?P pulls PMODE HIGH. An earlier draft pulled it low, which would have
LEGO ever did and can overheat them.
