daviskacer/odin/hardware/sensor_ports.kicad_sch

## KiCad design hardware/sensor_ports.kicad_sch (2026-10-21)

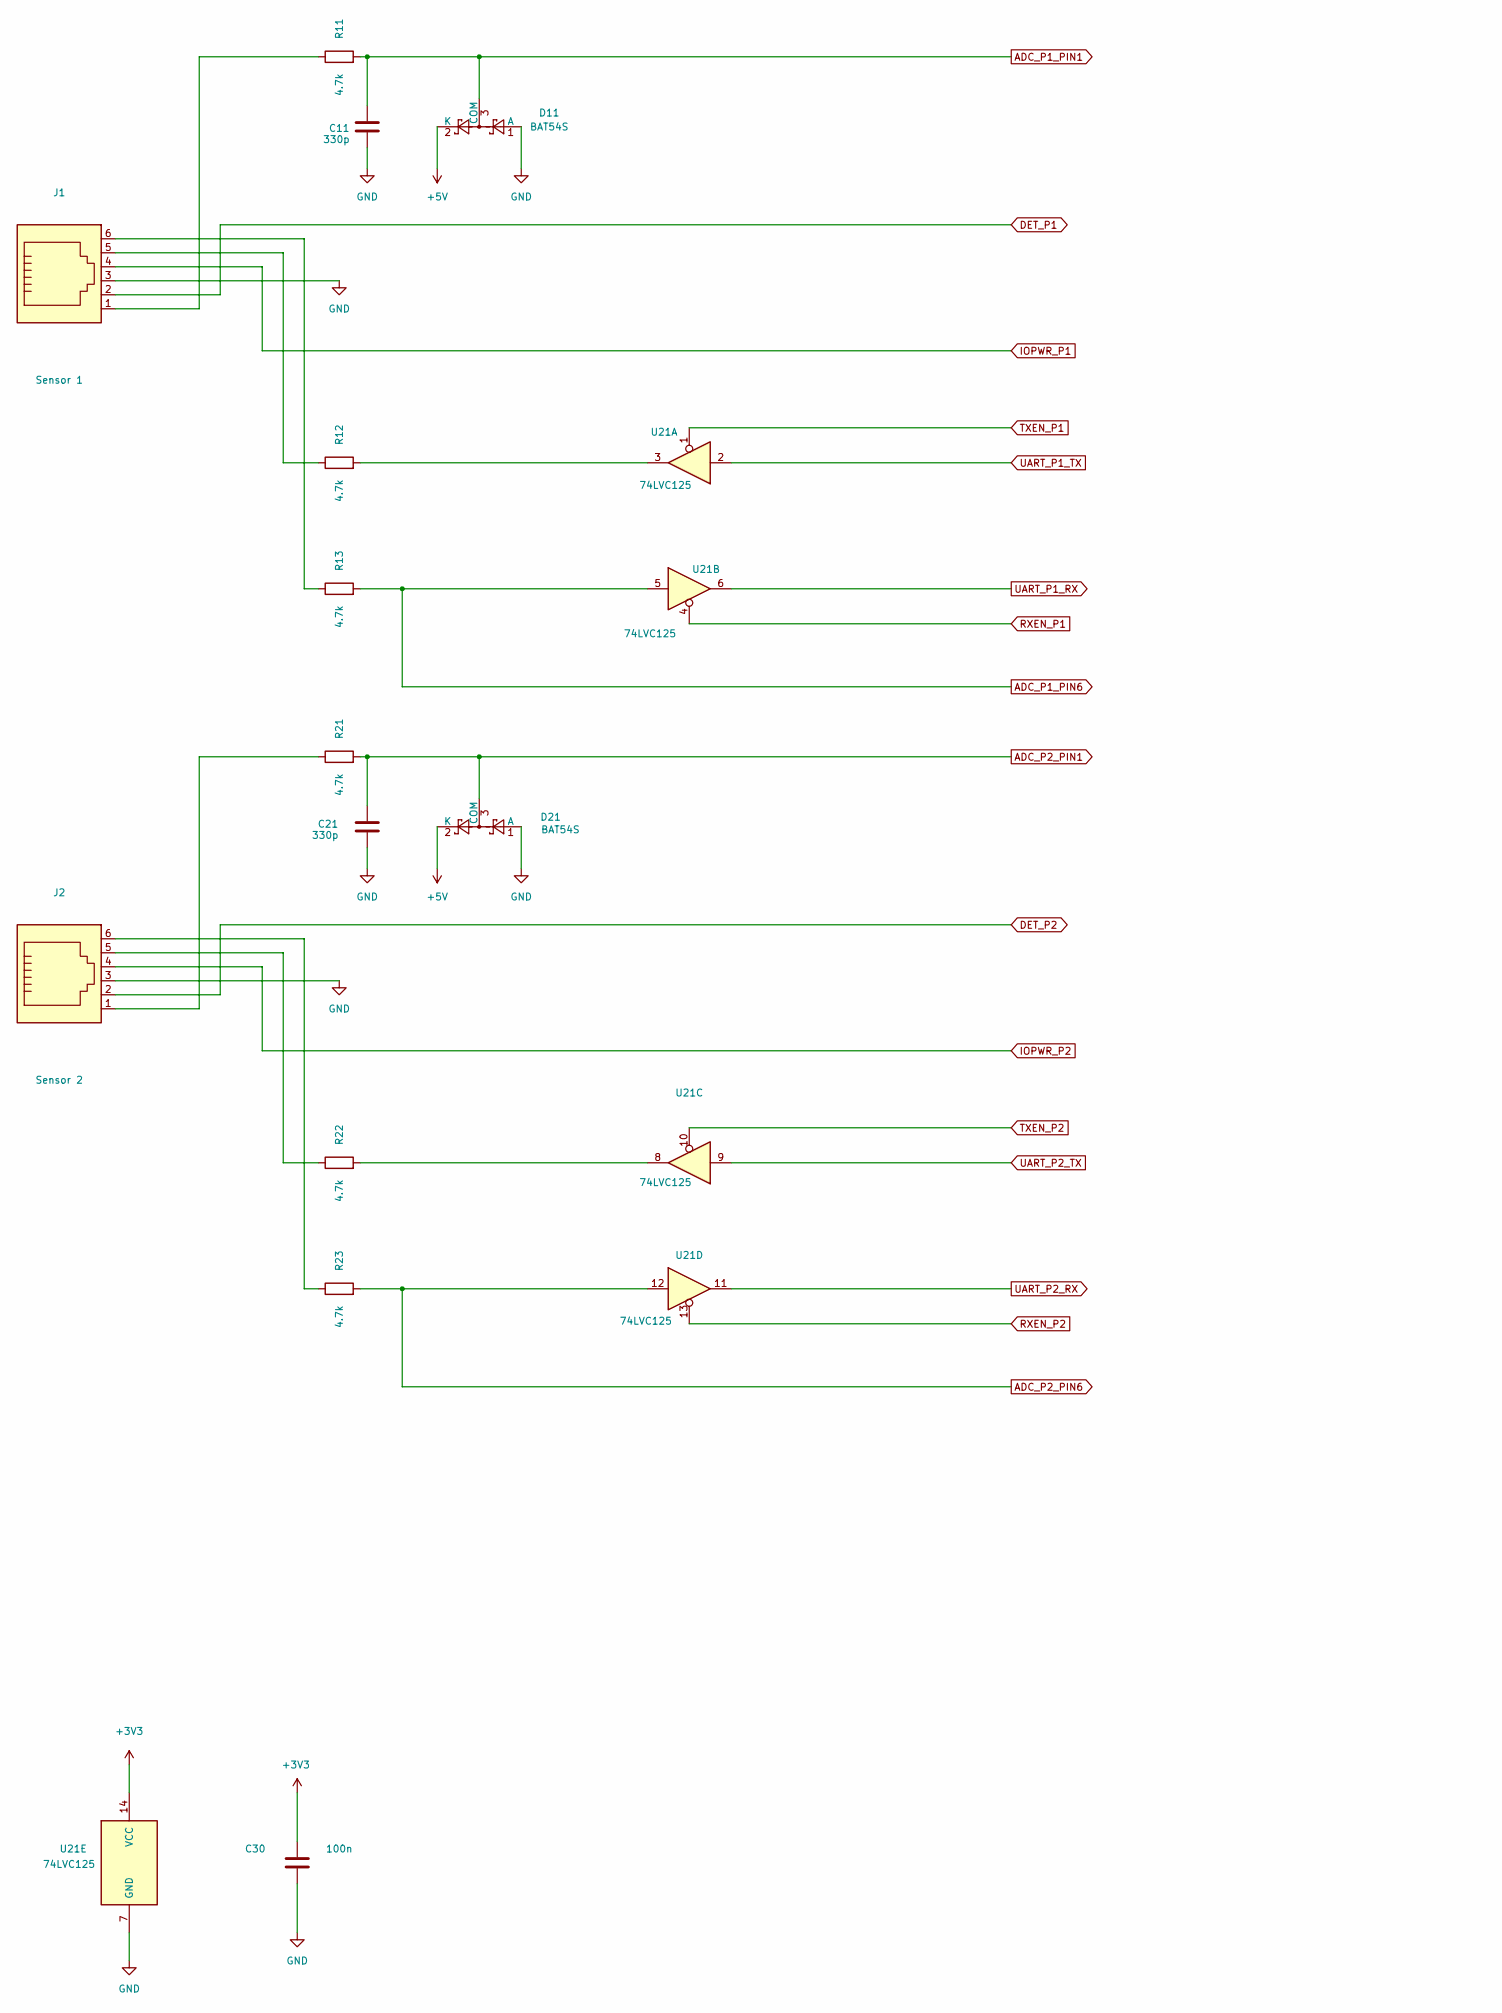
[picture p14: schematic sensor_ports.kicad_sch, part in row 1, column 1]

Parts:
C11, C21: 330p; C_0603_1608Metric
C30: 100n; C_0603_1608Metric
D11, D21: BAT54S; SOT-23
J1: Sensor 1
J2: Sensor 2
R11, R12, R13, R21, R22, R23: 4.7k; R_0603_1608Metric
U21: 74LVC125; TSSOP-14_4.4x5mm_P0.65mm

Connections:
+3V3: C30.1, U21.14 (VCC)
+5V: D11.2 (K), D21.2 (K)
ADC_P1_PIN1: C11.1, D11.3 (COM), R11.2
ADC_P1_PIN6: R13.2, U21.5
ADC_P2_PIN1: C21.1, D21.3 (COM), R21.2
ADC_P2_PIN6: R23.2, U21.12
DET_P1: J1.2
DET_P2: J2.2
GND: C11.2, C21.2, C30.2, D11.1 (A), D21.1 (A), J1.3, J2.3, U21.7 (GND)
IOPWR_P1: J1.4
IOPWR_P2: J2.4
unnamed: J1.1, R11.1
unnamed: J1.5, R12.1
unnamed: J1.6, R13.1
unnamed: J2.1, R21.1
unnamed: J2.5, R22.1
unnamed: J2.6, R23.1
unnamed: R12.2, U21.3
unnamed: R22.2, U21.8
RXEN_P1: U21.4
RXEN_P2: U21.13
TXEN_P1: U21.1
TXEN_P2: U21.10
UART_P1_RX: U21.6
UART_P1_TX: U21.2
UART_P2_RX: U21.11
UART_P2_TX: U21.9

Notes on the sheet:
enables per port are what let a port be tri-stated during auto-ID
J1-J4 need a custom RJ12 footprint: the 6P6C EV3 compatible jack uses an offset
Buffers are 74LVC125 quad 3-state, two ports per package:
latch and stock KiCad ships no 6P6C footprint at all.
Analog nets go to the external 5 V-referenced SPI ADC (MCP3008),
never to the ESP32-P4 ADC. See CLAUDE.md, GPIO budget.
and a faulty device isolated. Reproduce this - it is what makes
hot-plug safe.
U21 serves ports 1-2, U22 serves ports 3-4. Independent TX and RX
