daviskacer/odin/(commit log)

2026-10-21 Initial commit: ODIN dev carrier schematics, README and licenses
    [analog.kicad_sch, devio.kicad_sch, header.kicad_sch, motor_ports.kicad_sch, odin_dev.kicad_sch, sensor_ports.kicad_sch]
2026-10-21 Add odin custom symbol and footprint libraries
    The dev carrier's sym-lib-table and fp-lib-table resolve to ../symbols and
    ../footprints, so a fresh clone opens without missing-library warnings.
